RAFHA2413/Control_Navegacion_USV_STM32H562VGT6_v03/Evidencias_Experimentales/README.md

# Evidencias experimentales — PCB de control de navegación USV

Este directorio reúne **copias íntegras** de los archivos entregados en `PRUEBAS DE LA PCB.zip`. Se conserva el nombre y el contenido original de cada archivo; únicamente cambia su ubicación.

## Criterio de organización

Se agrupan los registros por código P01–P19 cuando aparece en el nombre original y, dentro de cada prueba, por formato. Los registros adicionales de inclinación y propulsión se asignaron **provisionalmente** por el nombre del archivo. Esta clasificación **no implica aprobación, conformidad ni ejecución completa** de un protocolo.

| Grupo | Archivos |
|---|---:|
| `P03` | 3 |
| `P04` | 3 |
| `P04_IMU_Adicional` | 1 |
| `P05` | 13 |
| `P06` | 4 |
| `P07` | 2 |
| `P08` | 3 |
| `P12` | 2 |
| `P13_P14_Propulsion` | 2 |
| `P13_P14_Propulsion_Adicional` | 1 |
| `P16` | 3 |
| `P17` | 2 |

## Integridad y trazabilidad

`INDICE_EVIDENCIAS.csv` contiene ruta, tamaño y SHA-256 de cada archivo. Los `.zip` internos se mantienen sin descomprimir para preservar la evidencia de origen y sus propios archivos auxiliares. Se conservan los archivos redundantes de las comparativas GNSS por pertenecer a paquetes originales.

## Interpretación de los datos

Estos ficheros son evidencias brutas o de análisis, no certificados de cumplimiento. Cualquier conclusión científica debe basarse en un análisis independiente de los registros y en los criterios definidos en el artículo y sus anexos. La existencia de un archivo con código de prueba no acredita por sí sola su resultado.

## Advertencia de publicación

**Revisar antes de enviar a un repositorio público.** Los archivos de P05 y sus ZIP auxiliares incluyen o pueden incluir latitudes, longitudes, trayectorias, fechas y horarios. Verificar autorizaciones institucionales y posibles datos sensibles de cualquier otro archivo. No publicar rutas operacionales no autorizadas.

## Fuente

Archivo suministrado por los autores: `PRUEBAS DE LA PCB.zip`. Inventario preparado el 22 de octubre de 2026.
