RAFHA2413/Control_Navegacion_USV_STM32H562VGT6_v03/Evidencias_Experimentales/P03/Analisis_XLSX/USV0067_PCB_A193_Informe_Analisis_P03_19OCT2026.xlsx

Sheet: Resumen
USV 0067 | PCB A193 — Informe de telemetría inicial
Registro P-03 · Análisis exploratorio, no acta de aprobación funcional
Dato | Resultado | Dato | Resultado
Fecha y hora local (UTC−5) | 2026-10-19 19:57:19 | Fin (UTC−5) | 2026-10-19 19:57:34
Duración exacta del CSV (s) | 14.598 | Filas de eventos | 1491
Variables por UART | 52 | Actualizaciones por variable | 30
Velocidad estimada (Hz) | 2.06 | Fuente | CSV original Teleplot
Firmware | Modo banco 13.2 + cambios locales | Tipo de conexión | USART6 TX → USB–TTL → COM5
Hallazgos que sí se desprenden del archivo
Área | Evidencia registrada | Dictamen limitado | Siguiente verificación
P-02 | firmware | main_alive 771→785 | Ejecución durante la captura | Prueba prolongada y revisar HardFault
P-03 | UART6 | 52 variables; 30 valores cada una | Transmisión PCB→PC | Enviar PCB STATUS con LF
P-04 | IMU | imu_ok=1, imu_data_ok=1 | Datos recibidos | Inclinación con referencia angular
P-05 | GNSS | gnss_rx_bytes=0 | Sin recepción observada | Comprobar conexión y salida L76K
P-06 | DS18B20 | temperatura_c = −100 °C | Lectura inválida | Inspeccionar 1-Wire J22 y pull-up
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
