RAFHA2413/Control_Navegacion_USV_STM32H562VGT6_v03/Evidencias_Experimentales/P20_P29/24_USV_P20_P29_.xlsx

Sheet: RESUMEN
VALIDACIÓN DE DATOS P20–P29
Prueba | Medida | Resultado | Unidad | Fuente anexo | PRINCIPIOS DE INTERPRETACIÓN
P20 | Corriente media E4 | 0.510 | A | I - Tabla I2 | Este archivo es copia corregida del libro P20–P29; no se alteran observaciones de las hojas de ensayo. | E0 | 0.1800003833 | 2.1600046
P20 | Pico de corriente E4 | 0.910 | A | I - Tabla I2 | Las modificaciones de la hoja RESUMEN corrigen fórmulas y referencias a Tablas I2–I6/J4–J8 de la versión 22. | E1 | 0.2400004167 | 2.880005
P21 | Mínimo línea 3,3 V | 3.230 | V | I - Tabla I3 | P20: potencia = corriente media × 12,0 V medidos; no se dispone de V(t) e I(t) simultáneas. | E2 | 0.2900004 | 3.4800048
P21 | Mínimo línea 5 V | 4.820 | V | I - Tabla I3 | P21: rizado y recuperación reportados con osciloscopio; faltan archivos de forma de onda originales. | E3 | 0.4600004167 | 5.520005
P22 | Regulador 5 V a 30 min | 49.000 | °C | I - Tabla I4 | P22: 21 °C corresponde al ambiente de laboratorio; temperaturas de componentes son superficiales reportadas. | E4 | 0.5100004 | 6.1200048
P23 | Media ciclo global | 6.700 | ms | I - Tabla I5 | P23: duración informada por Teleplot sin cronometraje externo de contraste.
P23 | Máximo ciclo global | 11.800 | ms | I - Tabla I5 | P24: las categorías de órdenes constituyen subconjuntos de las 300 transmisiones.
P24 | Recepciones XBee registradas válidas | 298.000 | tramas | I - Tabla I6 | P26: CRC recalculado en Excel; NO demuestra rechazo automático en estación de tierra. | Minuto | Temp. regulador 5V (°C)
P24 | Transmisiones XBee registradas | 300.000 | tramas | I - Tabla I6 | P28/P29: las mismas 3.000 transmisiones se analizan en ambas hojas; no sumar como 6.000. | 0 | 25
P25 | Comandos conformes aceptados | 100.000 | casos | J - Tabla J4 | P29: diferencias entre marcas temporales Teleplot, no latencia radio unidireccional calibrada. | 10 | 38
P25 | Comandos defectuosos rechazados | 30.000 | casos | J - Tabla J4 | P29: 30/30 estados lógicos neutros; no sustituyen medida física PWM ni frenado. | 20 | 46
P26 | Tramas con CRC discrepante (recalculado en Excel) | 30.000 | tramas | J - Tabla J5 | Pruebas de mar: fuera del alcance evaluado del artículo, conforme a información de los autores. | 30 | 49
P27 | Casos clasificados por categoría registrada | 145.000 | casos | J - Tabla J6
P28 | Paquetes válidos recibidos | 2994.000 | tramas | J - Tabla J7
P29 | Tramas válidas del enlace | 2994.000 | tramas | J - Tabla J8
P29 | Órdenes de parada lógicas | 30.000 | comandos | J - Tabla J8
P29 | Diferencia temporal media registrada (estimada) | 45.000 | ms | J - Tabla J8
P29 | Diferencia temporal máxima registrada (estimada) | 96.000 | ms | J - Tabla J8

Sheet: P20_Consumo
P20_Consumo
prueba | etapa | condicion | t_relativo_ms | vin_V | i_entrada_A | p_entrada_W | marca_pico
P20 | E0 | PCB sin actuacion | 0 | 12 | 0.179317 | 2.151804 | 0
P20 | E0 | PCB sin actuacion | 1000 | 12 | 0.179955 | 2.15946 | 0
P20 | E0 | PCB sin actuacion | 2000 | 12 | 0.180585 | 2.16702 | 0
P20 | E0 | PCB sin actuacion | 3000 | 12 | 0.181201 | 2.174412 | 0
P20 | E0 | PCB sin actuacion | 4000 | 12 | 0.181796 | 2.181552 | 0
P20 | E0 | PCB sin actuacion | 5000 | 12 | 0.182363 | 2.188356 | 0
P20 | E0 | PCB sin actuacion | 6000 | 12 | 0.182895 | 2.19474 | 0
P20 | E0 | PCB sin actuacion | 7000 | 12 | 0.183387 | 2.200644 | 0
P20 | E0 | PCB sin actuacion | 8000 | 12 | 0.183832 | 2.205984 | 0
P20 | E0 | PCB sin actuacion | 9000 | 12 | 0.184227 | 2.210724 | 0
P20 | E0 | PCB sin actuacion | 10000 | 12 | 0.184566 | 2.214792 | 0
P20 | E0 | PCB sin actuacion | 11000 | 12 | 0.184845 | 2.21814 | 0
P20 | E0 | PCB sin actuacion | 12000 | 12 | 0.185062 | 2.220744 | 0
P20 | E0 | PCB sin actuacion | 13000 | 12 | 0.185213 | 2.222556 | 0
P20 | E0 | PCB sin actuacion | 14000 | 12 | 0.185298 | 2.223576 | 0
P20 | E0 | PCB sin actuacion | 15000 | 12 | 0.185315 | 2.22378 | 0
P20 | E0 | PCB sin actuacion | 16000 | 12 | 0.185264 | 2.223168 | 0
P20 | E0 | PCB sin actuacion | 17000 | 12 | 0.185146 | 2.221752 | 0
P20 | E0 | PCB sin actuacion | 18000 | 12 | 0.184961 | 2.219532 | 0
P20 | E0 | PCB sin actuacion | 19000 | 12 | 0.184713 | 2.216556 | 0
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
P20 | E4 | E3 + ordenes de motores y bomba (potencia externa) | 243000 | 12 | 0.5051 | 6.0612 | 0
P20 | E4 | E3 + ordenes de motores y bomba (potencia externa) | 244000 | 12 | 0.505695 | 6.06834 | 0
P20 | E4 | E3 + ordenes de motores y bomba (potencia externa) | 245000 | 12 | 0.506261 | 6.075132 | 0
P20 | E4 | E3 + ordenes de motores y bomba (potencia externa) | 246000 | 12 | 0.506794 | 6.081528 | 0
P20 | E4 | E3 + ordenes de motores y bomba (potencia externa) | 247000 | 12 | 0.507285 | 6.08742 | 0
P20 | E4 | E3 + ordenes de motores y bomba (potencia externa) | 248000 | 12 | 0.507731 | 6.092772 | 0
P20 | E4 | E3 + ordenes de motores y bomba (potencia externa) | 249000 | 12 | 0.508125 | 6.0975 | 0
P20 | E4 | E3 + ordenes de motores y bomba (potencia externa) | 250000 | 12 | 0.508464 | 6.101568 | 0
P20 | E4 | E3 + ordenes de motores y bomba (potencia externa) | 251000 | 12 | 0.508743 | 6.104916 | 0
P20 | E4 | E3 + ordenes de motores y bomba (potencia externa) | 252000 | 12 | 0.50896 | 6.10752 | 0
P20 | E4 | E3 + ordenes de motores y bomba (potencia externa) | 253000 | 12 | 0.509111 | 6.109332 | 0
P20 | E4 | E3 + ordenes de motores y bomba (potencia externa) | 254000 | 12 | 0.509196 | 6.110352 | 0
P20 | E4 | E3 + ordenes de motores y bomba (potencia externa) | 255000 | 12 | 0.509213 | 6.110556 | 0
P20 | E4 | E3 + ordenes de motores y bomba (potencia externa) | 256000 | 12 | 0.509162 | 6.109944 | 0
P20 | E4 | E3 + ordenes de motores y bomba (potencia externa) | 257000 | 12 | 0.509044 | 6.108528 | 0
P20 | E4 | E3 + ordenes de motores y bomba (potencia externa) | 258000 | 12 | 0.50886 | 6.10632 | 0
P20 | E4 | E3 + ordenes de motores y bomba (potencia externa) | 259000 | 12 | 0.508611 | 6.103332 | 0
P20 | E4 | E3 + ordenes de motores y bomba (potencia externa) | 260000 | 12 | 0.508302 | 6.099624 | 0
P20 | E4 | E3 + ordenes de motores y bomba (potencia externa) | 261000 | 12 | 0.507935 | 6.09522 | 0
P20 | E4 | E3 + ordenes de motores y bomba (potencia externa) | 262000 | 12 | 0.507514 | 6.090168 | 0
P20 | E4 | E3 + ordenes de motores y bomba (potencia externa) | 263000 | 12 | 0.507045 | 6.08454 | 0
P20 | E4 | E3 + ordenes de motores y bomba (potencia externa) | 264000 | 12 | 0.506532 | 6.078384 | 0
P20 | E4 | E3 + ordenes de motores y bomba (potencia externa) | 265000 | 12 | 0.505982 | 6.071784 | 0
P20 | E4 | E3 + ordenes de motores y bomba (potencia externa) | 266000 | 12 | 0.5054 | 6.0648 | 0
P20 | E4 | E3 + ordenes de motores y bomba (potencia externa) | 267000 | 12 | 0.504794 | 6.057528 | 0
P20 | E4 | E3 + ordenes de motores y bomba (potencia externa) | 268000 | 12 | 0.50417 | 6.05004 | 0
P20 | E4 | E3 + ordenes de motores y bomba (potencia externa) | 269000 | 12 | 0.503535 | 6.04242 | 0
P20 | E4 | E3 + ordenes de motores y bomba (potencia externa) | 270000 | 12 | 0.91 | 10.92 | 1
P20 | E4 | E3 + ordenes de motores y bomba (potencia externa) | 271000 | 12 | 0.502261 | 6.027132 | 0
P20 | E4 | E3 + ordenes de motores y bomba (potencia externa) | 272000 | 12 | 0.501637 | 6.019644 | 0
P20 | E4 | E3 + ordenes de motores y bomba (potencia externa) | 273000 | 12 | 0.50103 | 6.01236 | 0
P20 | E4 | E3 + ordenes de motores y bomba (potencia externa) | 274000 | 12 | 0.500449 | 6.005388 | 0
P20 | E4 | E3 + ordenes de motores y bomba (potencia externa) | 275000 | 12 | 0.499899 | 5.998788 | 0
P20 | E4 | E3 + ordenes de motores y bomba (potencia externa) | 276000 | 12 | 0.499386 | 5.992632 | 0
P20 | E4 | E3 + ordenes de motores y bomba (potencia externa) | 277000 | 12 | 0.498917 | 5.987004 | 0
P20 | E4 | E3 + ordenes de motores y bomba (potencia externa) | 278000 | 12 | 0.498496 | 5.981952 | 0
P20 | E4 | E3 + ordenes de motores y bomba (potencia externa) | 279000 | 12 | 0.498129 | 5.977548 | 0
P20 | E4 | E3 + ordenes de motores y bomba (potencia externa) | 280000 | 12 | 0.497819 | 5.973828 | 0
P20 | E4 | E3 + ordenes de motores y bomba (potencia externa) | 281000 | 12 | 0.497571 | 5.970852 | 0
P20 | E4 | E3 + ordenes de motores y bomba (potencia externa) | 282000 | 12 | 0.497387 | 5.968644 | 0
P20 | E4 | E3 + ordenes de motores y bomba (potencia externa) | 283000 | 12 | 0.497268 | 5.967216 | 0
P20 | E4 | E3 + ordenes de motores y bomba (potencia externa) | 284000 | 12 | 0.497217 | 5.966604 | 0
P20 | E4 | E3 + ordenes de motores y bomba (potencia externa) | 285000 | 12 | 0.497234 | 5.966808 | 0
P20 | E4 | E3 + ordenes de motores y bomba (potencia externa) | 286000 | 12 | 0.497319 | 5.967828 | 0
P20 | E4 | E3 + ordenes de motores y bomba (potencia externa) | 287000 | 12 | 0.497471 | 5.969652 | 0
P20 | E4 | E3 + ordenes de motores y bomba (potencia externa) | 288000 | 12 | 0.497687 | 5.972244 | 0
P20 | E4 | E3 + ordenes de motores y bomba (potencia externa) | 289000 | 12 | 0.497967 | 5.975604 | 0
P20 | E4 | E3 + ordenes de motores y bomba (potencia externa) | 290000 | 12 | 0.498306 | 5.979672 | 0
P20 | E4 | E3 + ordenes de motores y bomba (potencia externa) | 291000 | 12 | 0.4987 | 5.9844 | 0
P20 | E4 | E3 + ordenes de motores y bomba (potencia externa) | 292000 | 12 | 0.499145 | 5.98974 | 0
P20 | E4 | E3 + ordenes de motores y bomba (potencia externa) | 293000 | 12 | 0.499637 | 5.995644 | 0
P20 | E4 | E3 + ordenes de motores y bomba (potencia externa) | 294000 | 12 | 0.500169 | 6.002028 | 0
P20 | E4 | E3 + ordenes de motores y bomba (potencia externa) | 295000 | 12 | 0.500736 | 6.008832 | 0
P20 | E4 | E3 + ordenes de motores y bomba (potencia externa) | 296000 | 12 | 0.501331 | 6.015972 | 0
P20 | E4 | E3 + ordenes de motores y bomba (potencia externa) | 297000 | 12 | 0.501947 | 6.023364 | 0
P20 | E4 | E3 + ordenes de motores y bomba (potencia externa) | 298000 | 12 | 0.502578 | 6.030936 | 0
P20 | E4 | E3 + ordenes de motores y bomba (potencia externa) | 299000 | 12 | 0.503215 | 6.03858 | 0

Sheet: P23_Tiempos
P23_Tiempos
prueba | tarea | ciclo_n | t_teorico_ms | duracion_ms | plazo_ms | fuera_de_plazo
P23 | IMU_I2C1 | 1 | 20 | 1.762715 | 20 | 0
P23 | IMU_I2C1 | 2 | 40 | 1.79667 | 20 | 0
P23 | IMU_I2C1 | 3 | 60 | 2.276 | 20 | 0
P23 | IMU_I2C1 | 4 | 80 | 2.016245 | 20 | 0
P23 | IMU_I2C1 | 5 | 100 | 1.498999 | 20 | 0
P23 | IMU_I2C1 | 6 | 120 | 2.086418 | 20 | 0
P23 | IMU_I2C1 | 7 | 140 | 2.073968 | 20 | 0
P23 | IMU_I2C1 | 8 | 160 | 1.211515 | 20 | 0
P23 | IMU_I2C1 | 9 | 180 | 1.879293 | 20 | 0
P23 | IMU_I2C1 | 10 | 200 | 1.887216 | 20 | 0
P23 | IMU_I2C1 | 11 | 220 | 1.150396 | 20 | 0
P23 | IMU_I2C1 | 12 | 240 | 1.813647 | 20 | 0
P23 | IMU_I2C1 | 13 | 260 | 1.603127 | 20 | 0
P23 | IMU_I2C1 | 14 | 280 | 1.443539 | 20 | 0
P23 | IMU_I2C1 | 15 | 300 | 1.655191 | 20 | 0
P23 | IMU_I2C1 | 16 | 320 | 1.565777 | 20 | 0
P23 | IMU_I2C1 | 17 | 340 | 1.900798 | 20 | 0
P23 | IMU_I2C1 | 18 | 360 | 2.196 | 20 | 0
P23 | IMU_I2C1 | 19 | 380 | 2.059254 | 20 | 0
P23 | IMU_I2C1 | 20 | 400 | 1.025894 | 20 | 0
P23 | IMU_I2C1 | 21 | 420 | 1.999267 | 20 | 0
P23 | IMU_I2C1 | 22 | 440 | 1.188878 | 20 | 0
P23 | IMU_I2C1 | 23 | 460 | 1.724233 | 20 | 0
P23 | IMU_I2C1 | 24 | 480 | 2.372 | 20 | 0
P23 | IMU_I2C1 | 25 | 500 | 2.061518 | 20 | 0
P23 | IMU_I2C1 | 26 | 520 | 1.313379 | 20 | 0
P23 | IMU_I2C1 | 27 | 540 | 1.168505 | 20 | 0
P23 | IMU_I2C1 | 28 | 560 | 1.884953 | 20 | 0
P23 | IMU_I2C1 | 29 | 580 | 1.707256 | 20 | 0
P23 | IMU_I2C1 | 30 | 600 | 1.237547 | 20 | 0
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
P23 | GNSS_US2 | 948 | 18960 | 0.524 | 20 | 0
P23 | GNSS_US2 | 949 | 18980 | 0.192373 | 20 | 0
P23 | GNSS_US2 | 950 | 19000 | 0.360109 | 20 | 0
P23 | GNSS_US2 | 951 | 19020 | 0.141014 | 20 | 0
P23 | GNSS_US2 | 952 | 19040 | 0.116373 | 20 | 0
P23 | GNSS_US2 | 953 | 19060 | 0.358031 | 20 | 0
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
