RAFHA2413/Control_Navegacion_USV_STM32H562VGT6_v03/Evidencias_Experimentales/INDICE_EVIDENCIAS.csv

codigo | tipo | archivo_original | ruta_relativa_en_paquete | bytes | sha256 | revision_publicacion
P03 | Analisis_XLSX | USV0067_PCB_A193_Informe_Analisis_P03_19OCT2026.xlsx | Evidencias_Experimentales/P03/Analisis_XLSX/USV0067_PCB_A193_Informe_Analisis_P03_19OCT2026.xlsx | 24751 | bf0d75cfed051277d66af35bf1fa67078f6775406b0299e3707b728b5551e502 | REVISAR_ANTES_DE_PUBLICAR
P03 | Graficas_y_Capturas | USV0067_PCB_A193_P03_UART6_Bidireccional_19OCT2026.png | Evidencias_Experimentales/P03/Graficas_y_Capturas/USV0067_PCB_A193_P03_UART6_Bidireccional_19OCT2026.png | 17008 | 0533cbf86c8d818af36d077606af17375cca2fefee244ee0420ba54a16f95037 | REVISAR_ANTES_DE_PUBLICAR
P03 | Registros_CSV | USV0067_PCB_A193_P03_Telemetria_Inicial_19OCT2026.csv | Evidencias_Experimentales/P03/Registros_CSV/USV0067_PCB_A193_P03_Telemetria_Inicial_19OCT2026.csv | 111140 | 077dfe2401a4587d238d4d108e9b397a6d4f7e06448e2f086d27c1a16f515104 | REVISAR_ANTES_DE_PUBLICAR
P04 | Registros_CSV | USV0067_PCB_A193_P04_IMU_Inclinacion_Lateral_19OCT2026.csv | Evidencias_Experimentales/P04/Registros_CSV/USV0067_PCB_A193_P04_IMU_Inclinacion_Lateral_19OCT2026.csv | 441700 | ffc191726b85a3fc6f24683c7584b86ada8407888aff66dc182baee0d2ff4e77 | REVISAR_ANTES_DE_PUBLICAR
P04 | Registros_CSV | USV0067_PCB_A193_P04_IMU_Movimiento_Exploratorio_19OCT2026.csv | Evidencias_Experimentales/P04/Registros_CSV/USV0067_PCB_A193_P04_IMU_Movimiento_Exploratorio_19OCT2026.csv | 223344 | 7305ba545b251598d1a0d17ec8b7f18799f04f3281cfc216d018aa40e5c0391b | REVISAR_ANTES_DE_PUBLICAR
P04 | Registros_CSV | USV0067_PCB_A193_P04_IMU_en_reposo_19OCT2026.csv | Evidencias_Experimentales/P04/Registros_CSV/USV0067_PCB_A193_P04_IMU_en_reposo_19OCT2026.csv | 221884 | a51f12714ee97c997bb390b60845492aedc58571a83ad200ef7fd156500c48f8 | REVISAR_ANTES_DE_PUBLICAR
P04_IMU_Adicional | Registros_CSV | inclinacion 15 grados .csv | Evidencias_Experimentales/P04_IMU_Adicional/Registros_CSV/inclinacion 15 grados .csv | 447880 | 775ffbfead5e92cb3cf4b9658a72a1506e55de374ca2289bddc1fbfd12439648 | REVISAR_ANTES_DE_PUBLICAR
P05 | Graficas_y_Capturas | USV0067_PCB_A193_P05_GNSS_RMC_GGA_Corregido_20OCT2026.png | Evidencias_Experimentales/P05/Graficas_y_Capturas/USV0067_PCB_A193_P05_GNSS_RMC_GGA_Corregido_20OCT2026.png | 125549 | ee1bdf03bffd92ed02f7a4de6a99d6c72ccb1553ee5a3a21c0541a2ece50102d | REVISAR_COORDENADAS
P05 | Graficas_y_Capturas | USV0067_PCB_A193_P05_GNSS_Variacion_Posicion_19OCT2026.png | Evidencias_Experimentales/P05/Graficas_y_Capturas/USV0067_PCB_A193_P05_GNSS_Variacion_Posicion_19OCT2026.png | 118169 | 5433a75692fdf3b61665f611204fec34ff5409235d457fbec31ab6ad0ce80286 | REVISAR_COORDENADAS
P05 | Paquetes_Complementarios | USV0067_P05_Evidencias_Comparativa_GNSS_FIT_20OCT2026.zip | Evidencias_Experimentales/P05/Paquetes_Complementarios/USV0067_P05_Evidencias_Comparativa_GNSS_FIT_20OCT2026.zip | 342068 | 085fd778043fde5c8cd554c80a43a0543776273310c5d1a2f5913f035182b95e | REVISAR_COORDENADAS
P05 | Paquetes_Complementarios | USV0067_P05_Evidencias_Tres_GPS_20OCT2026.zip | Evidencias_Experimentales/P05/Paquetes_Complementarios/USV0067_P05_Evidencias_Tres_GPS_20OCT2026.zip | 551925 | 58ac74c57a4f7796706f93ac68605524fade98d2f5c0a594fd405641b0637f8b | REVISAR_COORDENADAS
P05 | Paquetes_Complementarios | USV0067_P05_GNSS_Cielo_Evidencias_20OCT2026.zip | Evidencias_Experimentales/P05/Paquetes_Complementarios/USV0067_P05_GNSS_Cielo_Evidencias_20OCT2026.zip | 199744 | 921075cea0313021363fdafb6e3171c4e03c9bf523ad626859a8d4cb94174234 | REVISAR_COORDENADAS
P05 | Registros_CSV | USV0067_P05_Comparacion_GNSS_L76K_vs_Referencia_FIT_20OCT2026.csv | Evidencias_Experimentales/P05/Registros_CSV/USV0067_P05_Comparacion_GNSS_L76K_vs_Referencia_FIT_20OCT2026.csv | 42564 | 45ff96b6b54dd2775295072a915dc42f4f5ec0e7cdaa4e38355306e9bc98fc6f | REVISAR_COORDENADAS
P05 | Registros_CSV | USV0067_P05_Comparacion_Tres_GPS_Alineada_20OCT2026.csv | Evidencias_Experimentales/P05/Registros_CSV/USV0067_P05_Comparacion_Tres_GPS_Alineada_20OCT2026.csv | 65597 | da1701e92f14c6a9ebfc84f27cb0d1a2d7db8084f8164c19decc6d12825d553b | REVISAR_COORDENADAS
P05 | Registros_CSV | USV0067_P05_GNSS_L76K_Comparativa_20OCT2026.csv | Evidencias_Experimentales/P05/Registros_CSV/USV0067_P05_GNSS_L76K_Comparativa_20OCT2026.csv | 2416604 | 6b5eca619f7ae07af19c164fc0abd6c482b156d1f6de7e6fb4c47c0a793defeb | REVISAR_COORDENADAS
P05 | Registros_CSV | USV0067_PCB_A193_P05_GNSS_Prueba_Dinamica_Carro_20OCT2026.csv | Evidencias_Experimentales/P05/Registros_CSV/USV0067_PCB_A193_P05_GNSS_Prueba_Dinamica_Carro_20OCT2026.csv | 2256739 | a3f09924966d42c87e74b1586ff63a3826627d346573d21a8de517de8328eb01 | REVISAR_COORDENADAS
P05 | Registros_CSV | USV0067_PCB_A193_P05_GNSS_Prueba_Estatica_Cielo_20OCT2026.csv | Evidencias_Experimentales/P05/Registros_CSV/USV0067_PCB_A193_P05_GNSS_Prueba_Estatica_Cielo_20OCT2026.csv | 811132 | 0eb7c1f0146f987016c191a6e0db3b5063b097111f2b880fe95816263292a925 | REVISAR_COORDENADAS
P05 | Registros_CSV | USV0067_PCB_A193_P05_GNSS_RMC_GGA_Corregido_20OCT2026.csv | Evidencias_Experimentales/P05/Registros_CSV/USV0067_PCB_A193_P05_GNSS_RMC_GGA_Corregido_20OCT2026.csv | 626098 | c5cd3f58943404af2e44ac69da8c30d0c700d48b1211f2a68cc9230235f1c260 | REVISAR_COORDENADAS
P05 | Registros_CSV | USV0067_PCB_A193_P05_GNSS_Validacion_RMC_GGA_V2_20OCT2026.csv | Evidencias_Experimentales/P05/Registros_CSV/USV0067_PCB_A193_P05_GNSS_Validacion_RMC_GGA_V2_20OCT2026.csv | 636464 | 9f3f2a8e539f5481765515949d3bc2a65ee634401fc1d44b63ada9ef10873e6b | REVISAR_COORDENADAS
P05 | Registros_CSV | USV0067_PCB_A193_P05_GPS_GNSS_L76K_19OCT2026.csv | Evidencias_Experimentales/P05/Registros_CSV/USV0067_PCB_A193_P05_GPS_GNSS_L76K_19OCT2026.csv | 449983 | 46fa1d5f4a479c796fc9ad884102f4119079d0b2aedddf78ea7a0149665aa157 | REVISAR_COORDENADAS
P06 | Graficas_y_Capturas | USV0067_PCB_A193_P06_DS18B20_Enfriamiento_Grafica_19OCT2026.png | Evidencias_Experimentales/P06/Graficas_y_Capturas/USV0067_PCB_A193_P06_DS18B20_Enfriamiento_Grafica_19OCT2026.png | 81692 | d74e1b7328b3efb22de7b23bbf2dcc797467ba05aa13b5ac682af0956caf06ce | REVISAR_ANTES_DE_PUBLICAR
P06 | Graficas_y_Capturas | USV0067_PCB_A193_P06_Grafica_Temperatura_DS18B20_19OCT2026.png | Evidencias_Experimentales/P06/Graficas_y_Capturas/USV0067_PCB_A193_P06_Grafica_Temperatura_DS18B20_19OCT2026.png | 82301 | 6d63b48b94362a8c1c1f7c7fd0d61c8b9346c7d431b7a170b106b52bb8fdf16a | REVISAR_ANTES_DE_PUBLICAR
P06 | Registros_CSV | USV0067_PCB_A193_P06_DS18B20_Enfriamiento_19OCT2026.csv | Evidencias_Experimentales/P06/Registros_CSV/USV0067_PCB_A193_P06_DS18B20_Enfriamiento_19OCT2026.csv | 445116 | af4497b67bc8c00dcd7ebfda230b1c1ef3584c6333001441f0daf66de6737bbe | REVISAR_ANTES_DE_PUBLICAR
P06 | Registros_CSV | USV0067_PCB_A193_P06_Temperatura_DS18B20_19OCT2026.csv | Evidencias_Experimentales/P06/Registros_CSV/USV0067_PCB_A193_P06_Temperatura_DS18B20_19OCT2026.csv | 395108 | f638c14306b3b12ccdc4e03151b5773ba5eb50e5d70c2e1b919e4f3069b0823a | REVISAR_ANTES_DE_PUBLICAR
P07 | Graficas_y_Capturas | USV0067_PCB_A193_P07_Respuesta_Humedad_19OCT2026.png | Evidencias_Experimentales/P07/Graficas_y_Capturas/USV0067_PCB_A193_P07_Respuesta_Humedad_19OCT2026.png | 114164 | d604beb74ae249c3cb4fed6b0345939accaae9b3e5d33558e3a533b4fe6a3786 | REVISAR_ANTES_DE_PUBLICAR
P07 | Registros_CSV | USV0067_PCB_A193_P07_Humedad_Deteccion_Agua_19OCT2026.csv | Evidencias_Experimentales/P07/Registros_CSV/USV0067_PCB_A193_P07_Humedad_Deteccion_Agua_19OCT2026.csv | 390582 | 16ae3d32ff3e8de5b6e529fcad5e0c36241890544cefb2ecb1070c8ff1179ab5 | REVISAR_ANTES_DE_PUBLICAR
P08 | Graficas_y_Capturas | USV0067_PCB_A193_P08_Grafica_Voltaje_Bateria_19OCT2026.png | Evidencias_Experimentales/P08/Graficas_y_Capturas/USV0067_PCB_A193_P08_Grafica_Voltaje_Bateria_19OCT2026.png | 212248 | 94fbc97e29e995c2d1f45224045d2ef87a8711c54b2f6ab309d8c4edc282e9b7 | REVISAR_ANTES_DE_PUBLICAR
P08 | Graficas_y_Capturas | USV0067_PCB_A193_P08_Voltaje_Bateria_19OCT2026.png | Evidencias_Experimentales/P08/Graficas_y_Capturas/USV0067_PCB_A193_P08_Voltaje_Bateria_19OCT2026.png | 57930 | 08bf636507fd737afedbd11a6e87d056e6d01f58e6f4e90b263f1d27aac74d4e | REVISAR_ANTES_DE_PUBLICAR
P08 | Registros_CSV | USV0067_PCB_A193_P08_Voltaje_Bateria_19OCT2026.csv | Evidencias_Experimentales/P08/Registros_CSV/USV0067_PCB_A193_P08_Voltaje_Bateria_19OCT2026.csv | 441023 | d721cd8a39a1e9092b25fc38528b2bcf2a3c504ad3ece59dfb3be2e76ddd0c81 | REVISAR_ANTES_DE_PUBLICAR
P12 | Graficas_y_Capturas | USV 0067 — Prueba P-12_ secuencia de control del servomotor MG996R.png | Evidencias_Experimentales/P12/Graficas_y_Capturas/USV 0067 — Prueba P-12_ secuencia de control del servomotor MG996R.png | 23116 | 7ac243bdf4b12c16bbc881b95d1b01f2274927a0148db5f62894bc4707728237 | REVISAR_ANTES_DE_PUBLICAR
P12 | Registros_CSV | USV0067_PCB_A193_P12_Servo_MG996R_Movimiento_19OCT2026.csv | Evidencias_Experimentales/P12/Registros_CSV/USV0067_PCB_A193_P12_Servo_MG996R_Movimiento_19OCT2026.csv | 437599 | 97a58ada972c4a2b1ac1e8398fbc95fbd65a00d1a5c791b34dbce121f328b09a | REVISAR_ANTES_DE_PUBLICAR
P13_P14_Propulsion | Graficas_y_Capturas | USV0067_PCB_A193_P13_P14_Grafica_PWM_19OCT2026.png | Evidencias_Experimentales/P13_P14_Propulsion/Graficas_y_Capturas/USV0067_PCB_A193_P13_P14_Grafica_PWM_19OCT2026.png | 106239 | 5edd589e57f6b0512513f601c9a903bfa6ff9b4e2d74b2b958fd2eae50e11ab3 | REVISAR_ANTES_DE_PUBLICAR
P13_P14_Propulsion | Registros_CSV | USV0067_PCB_A193_P13_P14_Accionamiento_Motores_19OCT2026.csv | Evidencias_Experimentales/P13_P14_Propulsion/Registros_CSV/USV0067_PCB_A193_P13_P14_Accionamiento_Motores_19OCT2026.csv | 440691 | 34e1292d1ca341d6a12e23d8d1c8ae28004d800767ee59b6d5aa1bf93eff382b | REVISAR_ANTES_DE_PUBLICAR
P13_P14_Propulsion_Adicional | Registros_CSV | PRUEBAS PULSO MOTORES ESTRIBOR Y BABOR.csv | Evidencias_Experimentales/P13_P14_Propulsion_Adicional/Registros_CSV/PRUEBAS PULSO MOTORES ESTRIBOR Y BABOR.csv | 350623 | cd82d1d659e9422236ba34175315e6a6d370a7d2bed3379fa0e61b940eda2647 | REVISAR_ANTES_DE_PUBLICAR
P16 | Graficas_y_Capturas | USV0067_PCB_A193_P16_Bomba_Achique_19OCT2026.png | Evidencias_Experimentales/P16/Graficas_y_Capturas/USV0067_PCB_A193_P16_Bomba_Achique_19OCT2026.png | 9121 | 627703ae0b021b07eb0bb642e6ea1c4178c34db692d37fb995d5cf6a97ec8351 | REVISAR_ANTES_DE_PUBLICAR
P16 | Graficas_y_Capturas | USV0067_PCB_A193_P16_Bomba_Control_Teleplot.png | Evidencias_Experimentales/P16/Graficas_y_Capturas/USV0067_PCB_A193_P16_Bomba_Control_Teleplot.png | 90840 | 336e64a982eceba47c57cda846487d9e65f0983c0bf0354578280e032791aea3 | REVISAR_ANTES_DE_PUBLICAR
P16 | Registros_CSV | USV0067_PCB_A193_P16_Bomba_Achique_19OCT2026.csv | Evidencias_Experimentales/P16/Registros_CSV/USV0067_PCB_A193_P16_Bomba_Achique_19OCT2026.csv | 340270 | 17e2b49b85c98a3b675c38764b66ffdf8f05cc5deb387a1017b53851396a2a5b | REVISAR_ANTES_DE_PUBLICAR
P17 | Graficas_y_Capturas | USV0067_PCB_A193_P17_Seguridad_19OCT2026.png | Evidencias_Experimentales/P17/Graficas_y_Capturas/USV0067_PCB_A193_P17_Seguridad_19OCT2026.png | 8558 | 90adf4dad84a82a95c5cd417c63c3bc49b41acf6d363c152bc89e86971744d76 | REVISAR_ANTES_DE_PUBLICAR
P17 | Registros_CSV | USV0067_PCB_A193_P17_Seguridad_19OCT2026.csv | Evidencias_Experimentales/P17/Registros_CSV/USV0067_PCB_A193_P17_Seguridad_19OCT2026.csv | 442486 | af28d61253d06f3596366f92510c8e6a70d20d44d7dfbe40fdf209797f6cd455 | REVISAR_ANTES_DE_PUBLICAR
