RAFHA2413/Control_Navegacion_USV_STM32H562VGT6_v03/Evidencias_Experimentales/P20_P29/README.md

# Evidencias experimentales P20–P29 de la PCB USV

## Archivo original

- **Nombre esperado:** `24_USV_P20_P29_.xlsx`
- **Formato:** Libro Microsoft Excel (`.xlsx`)
- **Tamaño original:** 700.869 bytes
- **SHA-256 original:** `084a40f7020a8e8a1c7eb6d41e2dc815d8c9b08d050541772f4efa9f78bdcbcb`
- **Estado del libro antes de publicarlo:** estructura ZIP interna íntegra.

El libro contiene las siguientes 11 hojas, según la estructura original:

1. `RESUMEN`
2. `P20_Consumo`
3. `P21_Alimentacion`
4. `P22_Temperaturas`
5. `P23_Tiempos`
6. `P24_Concurrencia`
7. `P25_Formato`
8. `P26_CRC`
9. `P27_Clasificacion`
10. `P28_Paquetes`
11. `P29_Enlace`

## Publicación y verificación

Cargar el archivo original `24_USV_P20_P29_.xlsx` directamente a **esta carpeta**, sin cambiar su nombre ni modificar las hojas. El flujo de GitHub Actions **Verificar Excel P20-P29** contrastará su SHA-256 y la estructura de las 11 hojas, sin alterar los datos. Consultar la pestaña **Actions** para conocer el resultado de la verificación.

La verificación técnica de integridad del archivo no certifica, por sí sola, los resultados del ensayo ni sustituye la revisión metodológica de los anexos I, J y M. Este archivo constituye una evidencia documental complementaria para la trazabilidad de las pruebas.
