RAFHA2413/Control_Navegacion_USV_STM32H562VGT6_v03/Evidencias_Experimentales/P04/Registros_CSV/USV0067_PCB_A193_P04_IMU_Movimiento_Exploratorio_19OCT2026.csv

timestamp(ms) | humedad_adc | humedad_pct | temperatura_c | servo_angulo | servo_pwm_us | cmd_babor_rx_pct | cmd_estribor_rx_pct | cmd_camara_rx_deg | motor_babor_aplicado_pct | motor_estribor_aplicado_pct | motores_pwm_activos | motor_babor_pwm_us | motor_estribor_pwm_us | parada_rx | enlace_tierra_ok | failsafe_tierra | pusvu_rx_validas | bomba_achique | main_alive | imu_ok | imu_addr | imu_data_ok | roll | pitch | yaw | gnss_rx_eventos | gnss_rx_bytes | gps_rmc_ok | gps_gga_ok | gps_fix | gps_satelites | gps_hdop | gps_latitud | gps_longitud | gps_altitud_m | gps_velocidad_kph | gps_rumbo | corriente_adc | corriente_voltaje_v | corriente_a | bateria_adc | bateria_adc_v | bateria_voltaje_v | pcb_armado | pcb_motor_pulso | pcb_bomba_pulso | pcb_do_pulso | di1 | di2 | di3 | di4 | humedad_do
1792460355.774 | 4095
1792460355.776 |  | 0
1792460355.777 |  |  | -100
1792460355.779 |  |  |  | 0
1792460355.78 |  |  |  |  | 1500
1792460355.782 |  |  |  |  |  | 0
1792460355.784 |  |  |  |  |  |  | 0
1792460355.786 |  |  |  |  |  |  |  | 0
1792460355.789 |  |  |  |  |  |  |  |  | 0
1792460355.791 |  |  |  |  |  |  |  |  |  | 0
1792460355.794 |  |  |  |  |  |  |  |  |  |  | 1
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
