RAFHA2413/Control_Navegacion_USV_STM32H562VGT6_v03/Evidencias_Experimentales/P05/Registros_CSV/USV0067_P05_Comparacion_GNSS_L76K_vs_Referencia_FIT_20OCT2026.csv

hora_colombia | tiempo_desde_inicio_s | velocidad_l76k_kmh | velocidad_fit_kmh | diferencia_vel_kmh | error_absoluto_vel_kmh | rumbo_l76k_grados | rumbo_fit_derivado_6s_grados | error_angular_absoluto_grados | latitud_l76k | longitud_l76k | latitud_fit | longitud_fit | separacion_posiciones_m | velocidad_comparable | rumbo_comparable | gnss_rx_bytes_l76k
2026-10-20 10:24:33 | 0.0 | 12.78 | 11.8584 | 0.9216 | 0.9216 | 226.18 | 194.471 | 31.709 | 10.389102 | -75.531416 | 10.3890593 | -75.5314845 | 8.876 | True | True | 239.0
2026-10-20 10:24:34 | 1.0 | 12.2 | 11.7576 | 0.4424 | 0.4424 | 202.02 | 181.012 | 21.008 | 10.389075 | -75.531433 | 10.3890309 | -75.5314908 | 8.007 | True | True | 241.0
2026-10-20 10:24:35 | 2.0 | 12.52 | 11.5884 | 0.9316 | 0.9316 | 186.11 | 165.82 | 20.29 | 10.389045 | -75.531442 | 10.3890004 | -75.5314866 | 6.957 | True | True | 242.0
2026-10-20 10:24:36 | 3.0 | 11.76 | 11.556000000000001 | 0.204 | 0.204 | 174.99 | 153.9 | 21.09 | 10.389015 | -75.531443 | 10.3889755 | -75.5314736 | 5.524 | True | True | 242.0
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
