RAFHA2413/Control_Navegacion_USV_STM32H562VGT6_v03/Evidencias_Experimentales/P05/Registros_CSV/USV0067_P05_Comparacion_Tres_GPS_Alineada_20OCT2026.csv

hora_local_colombia | L76K_velocidad_kmh | Track_velocidad_kmh | FIT_velocidad_kmh | L76K_menos_Track_kmh | L76K_menos_FIT_kmh | L76K_rumbo_grados | Track_rumbo_grados | FIT_rumbo_derivado_6s_grados | comparacion_rumbo_valida_3_mas_8_kmh | L76K_lati_grados | L76K_long_grados | Track_lati_grados | Track_long_grados | FIT_lati_grados | FIT_long_grados | satellites_L76K | HDOP_L76K | GNSS_RX_bytes_L76K | GNSS_rx_eventos_L76K
2026-10-20 11:05:15 | 8.670000 | 9.700000 | 0.000000 | -1.030000 | 8.670000 | 181.890000 | 0.000000 |  | False | 10.389623 | -75.528403 | 10.389785 | -75.528483 | 10.389583 | -75.528437 | 19.000000 | 0.600000 | 219.000000 | 5674.000000
2026-10-20 11:05:16 | 13.150000 | 9.900000 | 0.000000 | 3.250000 | 13.150000 | 184.720000 | 0.000000 |  | False | 10.389595 | -75.528405 | 10.389574 | -75.528456 | 10.389544 | -75.528440 | 19.000000 | 0.600000 | 220.000000 | 5676.000000
2026-10-20 11:05:17 | 12.330000 | 10.800000 | 0.000000 | 1.530000 | 12.330000 | 185.880000 | 0.000000 |  | False | 10.389564 | -75.528408 | 10.389524 | -75.528470 | 10.389487 | -75.528410 | 19.000000 | 0.600000 | 220.000000 | 5678.000000
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
