RAFHA2413/Control_Navegacion_USV_STM32H562VGT6_v03/Evidencias_Experimentales/P05/Registros_CSV/USV0067_PCB_A193_P05_GNSS_Prueba_Estatica_Cielo_20OCT2026.csv

timestamp(ms) | humedad_adc | humedad_pct | temperatura_c | servo_angulo | servo_pwm_us | cmd_babor_rx_pct | cmd_estribor_rx_pct | cmd_camara_rx_deg | motor_babor_aplicado_pct | motor_estribor_aplicado_pct | motores_pwm_activos | motor_babor_pwm_us | motor_estribor_pwm_us | parada_rx | enlace_tierra_ok | failsafe_tierra | pusvu_rx_validas | bomba_achique | main_alive | imu_ok | imu_addr | imu_data_ok | roll | pitch | yaw | gnss_rx_eventos | gnss_rx_bytes | gps_rmc_ok | gps_gga_ok | gps_fix | gps_satelites | gps_hdop | gps_latitud | gps_longitud | gps_altitud_m | gps_velocidad_kph | gps_rumbo | corriente_adc | corriente_voltaje_v | corriente_a | bateria_adc | bateria_adc_v | bateria_voltaje_v | pcb_armado | pcb_motor_pulso | pcb_bomba_pulso | pcb_do_pulso | di1 | di2 | di3 | di4 | humedad_do
1792507290.004 | 4095
1792507290.007 |  | 0
1792507290.008 |  |  | -100
1792507290.01 |  |  |  | 0
1792507290.011 |  |  |  |  | 1500
1792507290.013 |  |  |  |  |  | 0
1792507290.016 |  |  |  |  |  |  | 0
1792507290.017 |  |  |  |  |  |  |  | 0
1792507290.02 |  |  |  |  |  |  |  |  | 0
1792507290.022 |  |  |  |  |  |  |  |  |  | 0
1792507290.025 |  |  |  |  |  |  |  |  |  |  | 1
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
