RAFHA2413/Control_Navegacion_USV_STM32H562VGT6_v03/Evidencias_Experimentales/P05/Graficas_y_Capturas/USV0067_PCB_A193_P05_GNSS_Variacion_Posicion_19OCT2026.png

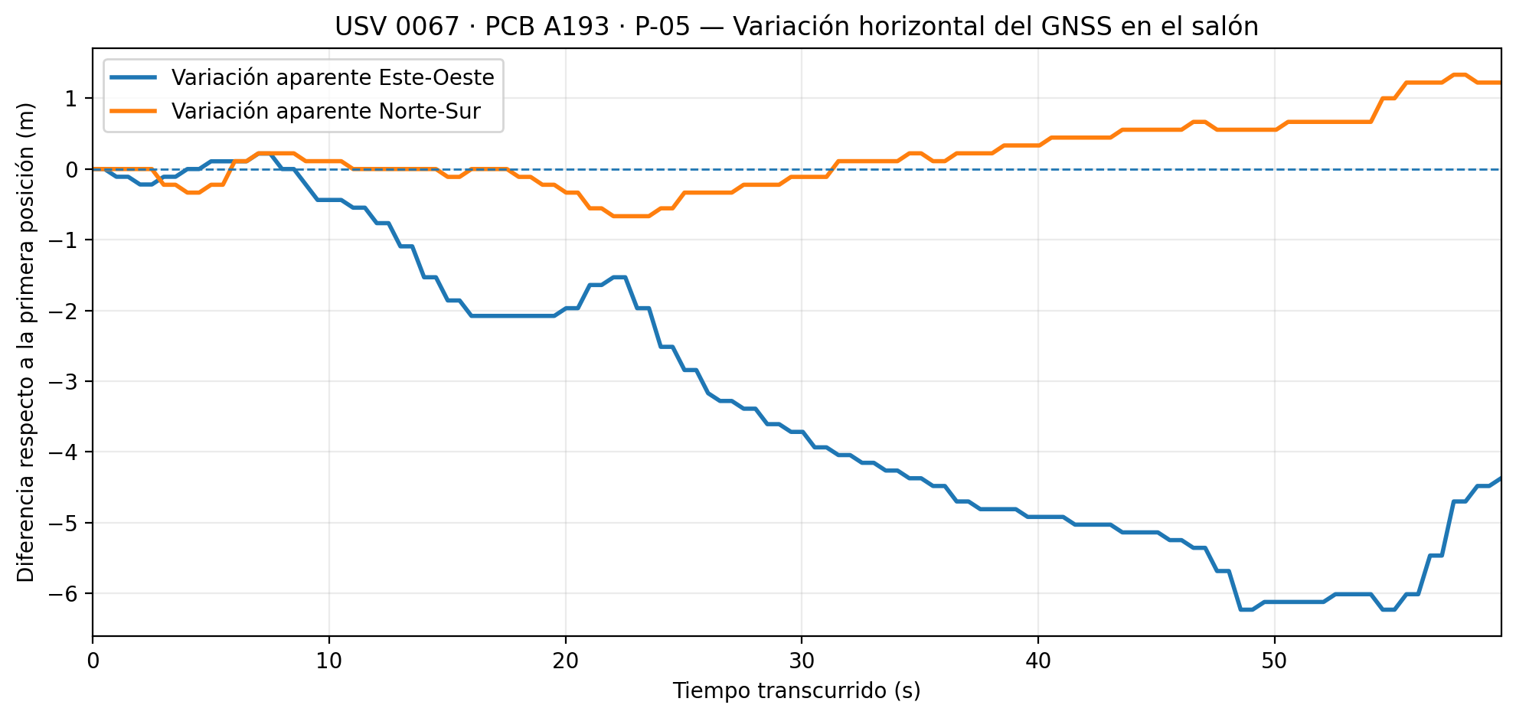
Evidencias_Experimentales/P05/Graficas_y_Capturas/USV0067_PCB_A193_P05_GNSS_Variacion_Posicion_19OCT2026.png
