RAFHA2413/Control_Navegacion_USV_STM32H562VGT6_v03/Evidencias_Experimentales/P08/Graficas_y_Capturas/USV0067_PCB_A193_P08_Grafica_Voltaje_Bateria_19OCT2026.png

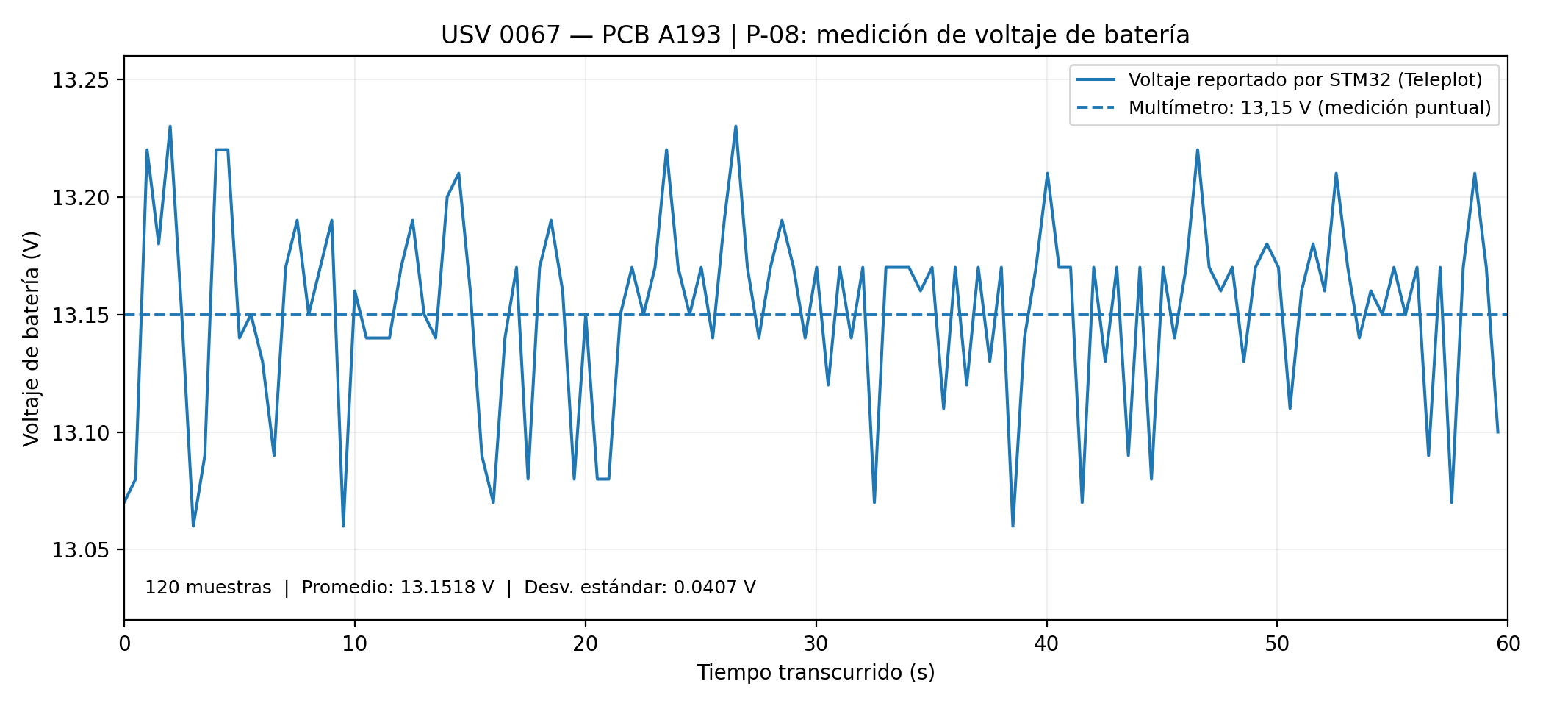
Evidencias_Experimentales/P08/Graficas_y_Capturas/USV0067_PCB_A193_P08_Grafica_Voltaje_Bateria_19OCT2026.png
