RAFHA2413/Control_Navegacion_USV_STM32H562VGT6_v03/Evidencias_Experimentales/P12/Graficas_y_Capturas/USV 0067 — Prueba P-12_ secuencia de control del servomotor MG996R.png

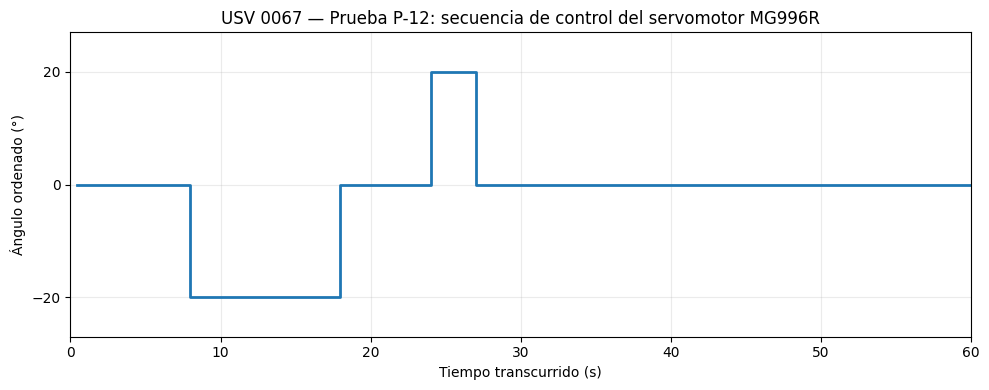
Evidencias_Experimentales/P12/Graficas_y_Capturas/USV 0067 — Prueba P-12_ secuencia de control del servomotor MG996R.png
