RAFHA2413/Control_Navegacion_USV_STM32H562VGT6_v03/Core/Src/main.c

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
/* Includes ------------------------------------------------------------------*/
#include "main.h"

/* USER CODE BEGIN Includes */

#include "servos.h"
#include "UARTRX.h"
#include <stdio.h>
#include "imu_bno085_i2c.h"
#include "TELEMETRIA_USV.h"
#include "trama_usv.h"
#include <math.h>
#include "stm32h5xx_hal_gpio.h"
#include "string.h"
#include "stdlib.h"
#include "uart.h"


#include "gps.h"
#include "adc_x.h"
#include "temp_ds18b20.h"
#include "usv_motores.h"
#include "pcb_banco.h"
#include "corriente_lem.h"

#include "stdio.h"
#include "stdlib.h"
#include "stdint.h"


/* USER CODE END Includes */

/* USER CODE BEGIN PD */

/*
 * PRUEBA 12.1:
 * La estacion puede ordenar y aplicar el rango completo -100..+100 %.
 * Se mantienen parada de emergencia y failsafe de enlace a 500 ms.
 */
#define USV_PRUEBA_MOTOR_LIMITE_PCT   100
#define USV_FAILSAFE_TIERRA_MS         500U

/* USER CODE END PD */

ADC_HandleTypeDef hadc1;
DMA_NodeTypeDef Node_GPDMA1_Channel1;
DMA_QListTypeDef List_GPDMA1_Channel1;
DMA_HandleTypeDef handle_GPDMA1_Channel1;

I2C_HandleTypeDef hi2c1;

TIM_HandleTypeDef htim3;

UART_HandleTypeDef huart1;
UART_HandleTypeDef huart2;
UART_HandleTypeDef huart3;
UART_HandleTypeDef huart6;
DMA_HandleTypeDef handle_GPDMA1_Channel0;
DMA_HandleTypeDef handle_GPDMA1_Channel2;

/* USER CODE BEGIN PV */
char texto[600];


volatile uint8_t imu_ok = 0U;
volatile uint8_t imu_addr = 0U;
volatile uint8_t imu_data_ok = 0U;

float imu_roll = 0.0f;
float imu_pitch = 0.0f;
float imu_yaw = 0.0f;

uint32_t imu_last_ms = 0U;
uint32_t teleplot_last_ms = 0U;

/* Heartbeat del lazo principal: incrementa una vez por segundo. */
uint32_t main_alive_last_ms = 0U;
uint32_t main_alive = 0U;

uint32_t temperatura_last_ms = 0U;
uint32_t temperatura_conversion_inicio_ms = 0U;
uint8_t temperatura_conversion_activa = 0U;
float temperatura_c = -100.0f;
uint8_t gps_rmc_ok = 0U;
uint8_t gps_gga_ok = 0U;
uint32_t gnss_rx_eventos = 0U;
uint32_t servo_test_last_ms = 0U;
uint8_t servo_test_estado = 0U;
float servo_test_angulo = 0.0f;
uint16_t motor_babor_pwm_us = PWM_NEUTRO;
uint16_t motor_estribor_pwm_us = PWM_NEUTRO;
uint8_t motores_pwm_activos = 0U;
uint32_t motores_test_last_ms = 0U;
uint8_t motores_test_estado = 0U;

/* Prueba local de bomba de achique por PB5 / ACHIQUE_CTRL. */
uint32_t bomba_test_last_ms = 0U;
uint8_t bomba_test_estado = 0U;

uint16_t corriente_adc_raw = 0U;
float corriente_voltaje_v = 0.0f;
float corriente_lem_a = 0.0f;

uint16_t bateria_adc_raw = 0U;
float bateria_adc_v = 0.0f;
float bateria_voltaje_v = 0.0f;

/* Ultima trama $PUSVU decodificada desde USART1 / estacion de tierra. */
USV_Comando comando_tierra;
uint8_t comando_tierra_valido = 0U;

/* Estado de control remoto para la prueba 12.0. */
int16_t cmd_babor_rx_pct = 0;
int16_t cmd_estribor_rx_pct = 0;
int16_t cmd_camara_rx_deg = 0;
int16_t motor_babor_aplicado_pct = 0;
int16_t motor_estribor_aplicado_pct = 0;
uint8_t parada_rx = 0U;
uint8_t enlace_tierra_ok = 0U;
uint8_t failsafe_tierra_activo = 1U;
uint32_t comando_tierra_ultimo_valido_ms = 0U;
uint32_t pusvu_rx_validas = 0U;

/* Diagnostico desacoplado de la recepcion para no bloquear USART1. */
uint32_t pusvu_diag_last_ms = 0U;
uint8_t pusvu_diag_pendiente = 0U;
uint8_t pusvu_diag_ultimo_valido = 0U;

char teleplot_tx[240];
uint8_t imu_raw[23];

int16_t imu_qi_raw = 0;
int16_t imu_qj_raw = 0;
int16_t imu_qk_raw = 0;
int16_t imu_qr_raw = 0;

volatile uint8_t imu_raw_ok = 0U;
volatile uint8_t imu_raw_channel = 0U;
volatile uint8_t imu_raw_report = 0U;
volatile uint16_t imu_raw_length = 0U;

/*
 * Diagnostico visual del enlace ESTACION -> BOTE.
 *
 * Mientras lleguen tramas por USART1, PB2 conmuta cada 250 ms.
 * Si pasan mas de 400 ms sin recibir nada, se detiene el parpadeo.
 */
uint32_t led_rx_ultimo_evento_ms = 0U;
uint32_t led_rx_ultimo_toggle_ms = 0U;
uint8_t led_rx_activo = 0U;
/* USER CODE END PV */

void SystemClock_Config(void);
static void MPU_Config(void);
static void MX_GPIO_Init(void);
static void MX_GPDMA1_Init(void);
static void MX_ICACHE_Init(void);
static void MX_USART1_UART_Init(void);
static void MX_USART2_UART_Init(void);
static void MX_USART6_UART_Init(void);
static void MX_I2C1_Init(void);
static void MX_TIM3_Init(void);
static void MX_USART3_UART_Init(void);
static void MX_ADC1_Init(void);
/* USER CODE BEGIN PFP */
void procesa_rx(void);
/* USER CODE END PFP */

/* USER CODE BEGIN 0 */

/*
 * Convierte los angulos reales del BNO085 al formato exigido por $PUSVD.
 *
 * - yaw:   0.0 ... 359.9 grados, almacenado x10.
 * - pitch: -90.0 ... +90.0 grados, almacenado x10.
 * - roll:  -90.0 ... +90.0 grados, almacenado x10.
 *
 * El BNO085 puede entregar roll fuera de +/-90 dependiendo de la orientacion.
 * La Trama Version 3 no admite ese rango, por eso se satura antes de enviarlo.
 */
static void USV_ActualizarTelemetriaIMU(
        float roll,
        float pitch,
        float yaw)
{
    int32_t yaw_x10;
    int32_t pitch_x10;
    int32_t roll_x10;

    while (yaw < 0.0f)
    {
        yaw += 360.0f;
    }

    while (yaw >= 360.0f)
    {
        yaw -= 360.0f;
    }

    if (pitch < -90.0f)
    {
        pitch = -90.0f;
    }
    else if (pitch > 90.0f)
    {
        pitch = 90.0f;
    }

    if (roll < -90.0f)
    {
        roll = -90.0f;
    }
    else if (roll > 90.0f)
    {
        roll = 90.0f;
    }

    yaw_x10 =
        (int32_t)((yaw * 10.0f) + 0.5f);

    pitch_x10 =
        (int32_t)((pitch >= 0.0f) ?
            ((pitch * 10.0f) + 0.5f) :
            ((pitch * 10.0f) - 0.5f));

    roll_x10 =
        (int32_t)((roll >= 0.0f) ?
            ((roll * 10.0f) + 0.5f) :
            ((roll * 10.0f) - 0.5f));

    if (yaw_x10 > 3599)
    {
        yaw_x10 = 3599;
    }

    TELEMETRIA_USV_IMU(
        &TELEMETRIA1,
        (uint16_t)yaw_x10,
        (int16_t)pitch_x10,
        (int16_t)roll_x10);
}

/*
 * Reconstruye el porcentaje con signo desde la estructura decodificada.
 * Positivo = avante, negativo = reversa.
 */
static int16_t USV_ComandoMotorFirmado(
        uint16_t potencia,
        uint8_t avante,
        uint8_t atras)
{
    if ((avante != 0U) && (atras == 0U))
    {
        return (int16_t)potencia;
    }

    if ((avante == 0U) && (atras != 0U))
    {
        return -(int16_t)potencia;
    }

    return 0;
}

/*
 * Limita el porcentaje de prueba y lo convierte a PWM ESC:
 * -100 % = 1000 us, 0 % = 1500 us, +100 % = 2000 us.
 * Para la prueba 12.1 se habilita el rango completo +/-100 %.
 */
static uint16_t USV_MotorPctAPwmPrueba(
        int16_t porcentaje,
        int16_t *porcentaje_aplicado)
{
    int16_t limitado = porcentaje;
    int32_t pwm;

    if (limitado > USV_PRUEBA_MOTOR_LIMITE_PCT)
    {
        limitado = USV_PRUEBA_MOTOR_LIMITE_PCT;
    }
    else if (limitado < -USV_PRUEBA_MOTOR_LIMITE_PCT)
    {
        limitado = -USV_PRUEBA_MOTOR_LIMITE_PCT;
    }

    if (porcentaje_aplicado != NULL)
    {
        *porcentaje_aplicado = limitado;
    }

    pwm = (int32_t)PWM_NEUTRO + ((int32_t)limitado * 5);

    if (pwm > PWM_MAX_ADELANTE)
    {
        pwm = PWM_MAX_ADELANTE;
    }
    else if (pwm < PWM_MAX_REVERSA)
    {
        pwm = PWM_MAX_REVERSA;
    }

    return (uint16_t)pwm;
}

/* void procesa_rx()
 {
  char procesa[100];
    char texto[100];
if (strstr(UARTRX1.trama_rx,"$PUSVU"))
	    {
	        strcpy(procesa, strtok(UARTRX1.trama_rx, "$"));  //inicia captura de tokens desde el =
	        strcpy(procesa, strtok(0, ","));  //captura hasta el /
strcpy(procesa, strtok(0, ","));  //captura hasta el /
strcpy(procesa, strtok(0, ","));  //captura hasta el /
strcpy(procesa, strtok(0, ","));  //captura hasta el /
strcpy(procesa, strtok(0, ","));  //captura hasta el /
strcpy(procesa, strtok(0, ","));  //captura hasta el /
 float serv=atof(procesa); // con signo
 sprintf(texto, "Servo= %.2f\r\n\r\n", serv);
 uartx_write_text(&huart1, texto);

 } 
  } */
/* USER CODE END 0 */

/**
  * @brief  The application entry point.
  * @retval int
  */
int main(void)
{

  /* MCU Configuration--------------------------------------------------------*/

  /* MPU Configuration--------------------------------------------------------*/
  MPU_Config();

  /* Reset of all peripherals, Initializes the Flash interface and the Systick. */
  HAL_Init();

  /* Configure the system clock */
  SystemClock_Config();

  /* Initialize all configured peripherals */
  MX_GPIO_Init();
  MX_GPDMA1_Init();
  MX_ICACHE_Init();
  MX_USART1_UART_Init();
  MX_USART2_UART_Init();
  MX_USART6_UART_Init();
  MX_I2C1_Init();
  MX_TIM3_Init();
  MX_USART3_UART_Init();
  MX_ADC1_Init();
  /* USER CODE BEGIN 2 */

/*
 * AUTOPRUEBA PB2:
 * Al arrancar, el LED cambia de estado durante 300 ms y vuelve al estado inicial.
 * Si este destello no se ve, el problema esta en PB2/LED y no en la UART.
 */
HAL_GPIO_WritePin(
    LED_RX_TIERRA_GPIO_Port,
    LED_RX_TIERRA_Pin,
    GPIO_PIN_SET);
HAL_Delay(300U);

HAL_GPIO_WritePin(
    LED_RX_TIERRA_GPIO_Port,
    LED_RX_TIERRA_Pin,
    GPIO_PIN_RESET);
HAL_Delay(300U);

// Inicializa la señal PWM en el pin PB0 (SERVO_CAMARA)
#if !PCB_BANCO_ACTIVO
SERVO_init(&SERVO1);
SERVO_ANG(&SERVO1, 0.0f);
#else
/* En banco, no generar PWM del servo hasta recibir orden manual. */
servo_test_angulo = 0.0f;
#endif // Posiciona inicialmente la cámara al centro (0°)

/*
 * PRUEBA LOCAL MOTORES 6.2:
 * Inicia únicamente las salidas PWM de propulsion en NEUTRO.
 * No se ejecuta USV_Motor_Calibrar() y no se ordena movimiento.
 * Babor    = PB4 / TIM3_CH1
 * Estribor = PB1 / TIM3_CH4
 */
if ((HAL_TIM_PWM_Start(&htim3, TIM_CHANNEL_1) == HAL_OK) &&
    (HAL_TIM_PWM_Start(&htim3, TIM_CHANNEL_4) == HAL_OK))
{
    USV_Motor_Set(&htim3, TIM_CHANNEL_1, PWM_NEUTRO);
    USV_Motor_Set(&htim3, TIM_CHANNEL_4, PWM_NEUTRO);

    motor_babor_pwm_us = PWM_NEUTRO;
    motor_estribor_pwm_us = PWM_NEUTRO;
    motores_pwm_activos = 1U;
}

/*
 * La prueba de bomba inicia con el rele desenergizado.
 * PB5 es open-drain y el rele es activo en LOW:
 * SET = alta impedancia = OFF.
 * RESET = 0 V = ON.
 */
HAL_GPIO_WritePin(
    ACHIQUE_CTRL_GPIO_Port,
    ACHIQUE_CTRL_Pin,
    GPIO_PIN_SET);
bomba_test_estado = 0U;
bomba_test_last_ms = HAL_GetTick();

uartx_write_text(&huart6, "INICIANDO\r\n");
#if PCB_BANCO_ACTIVO
PCB_Banco_Iniciar();
#endif
//uartRX_it_idle_dma_init(&UARTRX1);
uartRX_it_idle_dma_init(&GPS_UARTRX);   // USART1 / estacion de tierra
uartRX_it_idle_dma_init(&GNSS_UARTRX);   // USART2 / GPS L76K

// Inicializa la telemetria oficial $PUSVD por USART1 / XBee
TELEMETRIA_USV_init(&TELEMETRIA1);

// Inicializa BNO085
imu_ok = IMU_Init();
imu_addr = IMU_GetAddress7bit();

// Inicializa DS18B20 / 1-Wire en PC2 (TEMPE)
TEMPE_Init();

/*
 * Inicia ADC1 por DMA usando la libreria adc_x.
 * CubeMX tiene 3 conversiones:
 * [0] PA0, [1] PC1, [2] PC3 (humedad).
 * PC2 ya no pertenece al ADC: se usa para DS18B20 / 1-Wire.
 * Se pasa 3 de forma explicita para no modificar la libreria adc_x.
 */
ADC_Read_DMA(&hadc1, 3U, adc1_codigo);

  /* USER CODE END 2 */

  /* Infinite loop */
  /* USER CODE BEGIN WHILE */
  while (1)
  {
#if PCB_BANCO_ACTIVO
    PCB_Banco_Tarea();
#endif
    /*
     * Heartbeat de diagnostico.
     * Si main_alive sigue aumentando, el while(1) continua ejecutandose.
     */
    if ((uint32_t)(HAL_GetTick() - main_alive_last_ms) >= 1000U)
    {
        main_alive_last_ms = HAL_GetTick();
        main_alive++;
    }

    /* Lectura IMU cada 50 ms */
    if ((HAL_GetTick() - imu_last_ms) >= 50U)
    {
        imu_last_ms = HAL_GetTick();

        if (IMU_ReadEuler(
                &imu_roll,
                &imu_pitch,
                &imu_yaw) != 0U)
        {
            imu_data_ok = 1U;

            USV_ActualizarTelemetriaIMU(
                imu_roll,
                imu_pitch,
                imu_yaw);
        }
    }

    /*
     * PRUEBA 12.0:
     * Servo y motores ya no se fuerzan aqui a una posicion fija.
     * Las salidas se actualizan exclusivamente cuando llega una $PUSVU
     * valida y por el failsafe de perdida de enlace definido mas abajo.
     */

    /*
     * PRUEBA 12.0:
     * La bomba permanece desactivada. Esta etapa habilita unicamente
     * servo de camara y los dos motores de propulsion.
     */
#if !PCB_BANCO_ACTIVO
    HAL_GPIO_WritePin(
        ACHIQUE_CTRL_GPIO_Port,
        ACHIQUE_CTRL_Pin,
        GPIO_PIN_SET);
    bomba_test_estado = 0U;
#endif

    /*
     * TEMPERATURA DS18B20 NO BLOQUEANTE:
     *
     * La conversion se inicia cada 2 s y el main continua ejecutandose.
     * Transcurridos 750 ms se lee el scratchpad. De esta forma USART1,
     * Teleplot, IMU y el resto de tareas siguen siendo atendidos durante
     * el tiempo de conversion del sensor.
     */
    {
        uint32_t ahora_temp = HAL_GetTick();

        if (temperatura_conversion_activa == 0U)
        {
            if ((uint32_t)(ahora_temp - temperatura_last_ms) >= 2000U)
            {
                temperatura_last_ms = ahora_temp;

                if (TEMPE_StartConversion() != 0U)
                {
                    temperatura_conversion_inicio_ms = ahora_temp;
                    temperatura_conversion_activa = 1U;
                }
                else
                {
                    temperatura_c = -100.0f;
                }
            }
        }
        else if ((uint32_t)(ahora_temp - temperatura_conversion_inicio_ms) >= 750U)
        {
            temperatura_c = TEMPE_ReadResult();
            temperatura_conversion_activa = 0U;
        }
    }

    /*
     * TELEPLOT SEGURO 11.4:
     * Se limita a 2 Hz para reducir la carga de USART6 durante la prueba
     * continua de comunicacion con la estacion de tierra.
     */
    if ((HAL_GetTick() - teleplot_last_ms) >= 500U)
    {
        float humedad_pct;
        int len;

        teleplot_last_ms = HAL_GetTick();

        /*
         * SENSOR DE CORRIENTE LEM HASS 200-S:
         * PA0 = ADC1_INP0 = adc1_codigo[0].
         * Se conserva intacta la libreria corriente_lem.
         */
        corriente_adc_raw = adc1_codigo[0];
        corriente_voltaje_v =
            ((float)corriente_adc_raw / STM32_ADC_MAX_CODES) *
            STM32_ADC_VREF;
        corriente_lem_a =
            LEM_HASS200_ObtenerCorriente(corriente_adc_raw);

        /*
         * SENSOR DE VOLTAJE DE BATERIA:
         * PC1 = ADC1_INP11 = adc1_codigo[1].
         * Divisor nominal: R1=20 kOhm, R2=4.7 kOhm.
         * Factor nominal = (20k + 4.7k) / 4.7k = 5.255.
         *
         * Para esta primera prueba se usa el factor nominal y se compara
         * contra el multimetro antes de aplicar cualquier calibracion.
         */
        bateria_adc_raw = adc1_codigo[1];
        bateria_adc_v =
            ((float)bateria_adc_raw / 4095.0f) * 3.3f;
        bateria_voltaje_v =
            bateria_adc_v * 5.255f;

        /*
         * INTEGRACION $PUSVD 9.1:
         * Convierte las mediciones electricas al formato x10 de la trama.
         * Se preservan temperatura e inundacion hasta integrarlas en su etapa.
         */
        {
            float bateria_tx_v = bateria_voltaje_v;
            float corriente_tx_a = corriente_lem_a;
            uint16_t bateria_tx_x10;
            uint16_t corriente_tx_x10;

            if (bateria_tx_v < 0.0f)
            {
                bateria_tx_v = 0.0f;
            }
            else if (bateria_tx_v > 14.0f)
            {
                bateria_tx_v = 14.0f;
            }

            if (corriente_tx_a < 0.0f)
            {
                corriente_tx_a = 0.0f;
            }
            else if (corriente_tx_a > 100.0f)
            {
                corriente_tx_a = 100.0f;
            }

            bateria_tx_x10 =
                (uint16_t)((bateria_tx_v * 10.0f) + 0.5f);

            corriente_tx_x10 =
                (uint16_t)((corriente_tx_a * 10.0f) + 0.5f);

            TELEMETRIA_USV_SENSORES(
                &TELEMETRIA1,
                TELEMETRIA1.datos.temperatura_x10,
                TELEMETRIA1.datos.inundacion,
                bateria_tx_x10,
                corriente_tx_x10);
        }

        humedad_pct =
            ((4095.0f - (float)adc1_codigo[2]) * 100.0f) /
            (4095.0f - 1466.0f);

        if (humedad_pct < 0.0f)
        {
            humedad_pct = 0.0f;
        }
        else if (humedad_pct > 100.0f)
        {
            humedad_pct = 100.0f;
        }

        /* Bloque 1: sensores basicos y servo. */
        len = snprintf(
            texto,
            sizeof(texto),
            ">humedad_adc:%u\r\n"
            ">humedad_pct:%.1f\r\n"
            ">temperatura_c:%.2f\r\n"
            ">servo_angulo:%.1f\r\n"
            ">servo_pwm_us:%lu\r\n"
            ">cmd_babor_rx_pct:%d\r\n"
            ">cmd_estribor_rx_pct:%d\r\n"
            ">cmd_camara_rx_deg:%d\r\n"
            ">motor_babor_aplicado_pct:%d\r\n"
            ">motor_estribor_aplicado_pct:%d\r\n"
            ">motores_pwm_activos:%u\r\n"
            ">motor_babor_pwm_us:%u\r\n"
            ">motor_estribor_pwm_us:%u\r\n"
            ">parada_rx:%u\r\n"
            ">enlace_tierra_ok:%u\r\n"
            ">failsafe_tierra:%u\r\n"
            ">pusvu_rx_validas:%lu\r\n"
            ">bomba_achique:%u\r\n"
            ">main_alive:%lu\r\n",
            (unsigned int)adc1_codigo[2],
            humedad_pct,
            temperatura_c,
            servo_test_angulo,
            (unsigned long)TIM3->CCR3,
            (int)cmd_babor_rx_pct,
            (int)cmd_estribor_rx_pct,
            (int)cmd_camara_rx_deg,
            (int)motor_babor_aplicado_pct,
            (int)motor_estribor_aplicado_pct,
            (unsigned int)motores_pwm_activos,
            (unsigned int)motor_babor_pwm_us,
            (unsigned int)motor_estribor_pwm_us,
            (unsigned int)parada_rx,
            (unsigned int)enlace_tierra_ok,
            (unsigned int)failsafe_tierra_activo,
            (unsigned long)pusvu_rx_validas,
            (unsigned int)bomba_test_estado,
            (unsigned long)main_alive);

        if ((len > 0) && ((size_t)len < sizeof(texto)))
        {
            uartx_write_text(&huart6, texto);
        }

        /* Bloque 2: diagnostico IMU. */
        len = snprintf(
            texto,
            sizeof(texto),
            ">imu_ok:%u\r\n"
            ">imu_addr:%u\r\n"
            ">imu_data_ok:%u\r\n"
            ">roll:%.2f\r\n"
            ">pitch:%.2f\r\n"
            ">yaw:%.2f\r\n",
            (unsigned int)imu_ok,
            (unsigned int)imu_addr,
            (unsigned int)imu_data_ok,
            imu_roll,
            imu_pitch,
            imu_yaw);

        if ((len > 0) && ((size_t)len < sizeof(texto)))
        {
            uartx_write_text(&huart6, texto);
        }

        /* Bloque 3: estado de recepcion GNSS. */
        len = snprintf(
            texto,
            sizeof(texto),
            ">gnss_rx_eventos:%lu\r\n"
            ">gnss_rx_bytes:%u\r\n"
            ">gps_rmc_ok:%u\r\n"
            ">gps_gga_ok:%u\r\n"
            ">gps_fix:%d\r\n"
            ">gps_satelites:%d\r\n"
            ">gps_hdop:%.2f\r\n",
            (unsigned long)gnss_rx_eventos,
            (unsigned int)GNSS_UARTRX.num_datos,
            (unsigned int)gps_rmc_ok,
            (unsigned int)gps_gga_ok,
            (int)gps_modo,
            (int)gps_satelites,
            gps_hor_dilu);

        if ((len > 0) && ((size_t)len < sizeof(texto)))
        {
            uartx_write_text(&huart6, texto);
        }

        /* Bloque 4: datos de navegacion GNSS. */
        len = snprintf(
            texto,
            sizeof(texto),
            ">gps_latitud:%.6f\r\n"
            ">gps_longitud:%.6f\r\n"
            ">gps_altitud_m:%.2f\r\n"
            ">gps_velocidad_kph:%.2f\r\n"
            ">gps_rumbo:%.2f\r\n",
            latitud,
            longitud,
            gps_altura,
            gps_vel_kph,
            gps_rumbo);

        if ((len > 0) && ((size_t)len < sizeof(texto)))
        {
            uartx_write_text(&huart6, texto);
        }

        /* Bloque 5: sensor de corriente LEM por PA0 / ADC1_INP0. */
        len = snprintf(
            texto,
            sizeof(texto),
            ">corriente_adc:%u\r\n"
            ">corriente_voltaje_v:%.3f\r\n"
            ">corriente_a:%.2f\r\n",
            (unsigned int)corriente_adc_raw,
            corriente_voltaje_v,
            corriente_lem_a);

        if ((len > 0) && ((size_t)len < sizeof(texto)))
        {
            uartx_write_text(&huart6, texto);
        }

        /* Bloque 6: voltaje de bateria por PC1 / ADC1_INP11. */
        len = snprintf(
            texto,
            sizeof(texto),
            ">bateria_adc:%u\r\n"
            ">bateria_adc_v:%.3f\r\n"
            ">bateria_voltaje_v:%.2f\r\n",
            (unsigned int)bateria_adc_raw,
            bateria_adc_v,
            bateria_voltaje_v);

        if ((len > 0) && ((size_t)len < sizeof(texto)))
        {
            uartx_write_text(&huart6, texto);
        }
#if PCB_BANCO_ACTIVO
        len = snprintf(texto, sizeof(texto),
            ">pcb_armado:%u\r\n>pcb_motor_pulso:%u\r\n"
            ">pcb_bomba_pulso:%u\r\n>pcb_do_pulso:%u\r\n"
            ">di1:%u\r\n>di2:%u\r\n>di3:%u\r\n>di4:%u\r\n"
            ">humedad_do:%u\r\n",
            (unsigned int)PCB_Banco_Armado(),
            (unsigned int)PCB_Banco_MotorActivo(),
            (unsigned int)PCB_Banco_BombaActiva(),
            (unsigned int)PCB_Banco_SalidaActiva(),
            (unsigned int)HAL_GPIO_ReadPin(DI1_PA4_GPIO_Port, DI1_PA4_Pin),
            (unsigned int)HAL_GPIO_ReadPin(DI2_PA5_GPIO_Port, DI2_PA5_Pin),
            (unsigned int)HAL_GPIO_ReadPin(DI3_PA6_GPIO_Port, DI3_PA6_Pin),
            (unsigned int)HAL_GPIO_ReadPin(DI4_PA7_GPIO_Port, DI4_PA7_Pin),
            (unsigned int)HAL_GPIO_ReadPin(HUMIDITY_DO_GPIO_Port, HUMIDITY_DO_Pin));
        if ((len > 0) && ((size_t)len < sizeof(texto)))
            uartx_write_text(&huart6, texto);
#endif
    }

    /* Envío a Teleplot cada 200 ms */
    /* if ((HAL_GetTick() - teleplot_last_ms) >= 200U)
    {
        teleplot_last_ms = HAL_GetTick();

        int len = snprintf(
            teleplot_tx,
            sizeof(teleplot_tx),
            ">imu_ok:%u\r\n"
            ">imu_addr:%u\r\n"
            ">imu_data_ok:%u\r\n"
            ">roll:%.2f\r\n"
            ">pitch:%.2f\r\n"
            ">yaw:%.2f\r\n"
            ">rx_eventos:%lu\r\n"
            ">tramas_validas:%lu\r\n"
            ">camara_rx:%d\r\n"
            ">servo_ccr3:%lu\r\n"
            ">pb2_estado:%u\r\n"
            ">enlace_tierra:%u\r\n",
            (unsigned int)imu_ok,
            (unsigned int)imu_addr,
            (unsigned int)imu_data_ok,
            imu_roll,
            imu_pitch,
            imu_yaw,
            (unsigned long)usv_rx_eventos,
            (unsigned long)usv_tramas_validas,
            (int)usv_camara_recibida,
            (unsigned long)TIM3->CCR3,
            (unsigned int)HAL_GPIO_ReadPin(
                LED_RX_TIERRA_GPIO_Port,
                LED_RX_TIERRA_Pin),
            (unsigned int)led_rx_activo);

        if (len > 0)
        {
            HAL_UART_Transmit(
                &huart6,
                (uint8_t *)teleplot_tx,
                (uint16_t)len,
                100U);
        }
    } */

    /*
     * PRUEBA 12.0 - CONTROL REAL DESDE $PUSVU:
     *
     * Una trama valida actualiza inmediatamente:
     * - servo PB0 / TIM3_CH3;
     * - motor babor PB4 / TIM3_CH1;
     * - motor estribor PB1 / TIM3_CH4.
     *
     * Los motores usan el rango completo -100..+100 %.
     * parada=1 mantiene ambos ESC en NEUTRO.
     */
    if (GPS_UARTRX.flag_rx == 1)
    {
        uint32_t ahora_rx = HAL_GetTick();

        led_rx_ultimo_evento_ms = ahora_rx;
        led_rx_activo = 1U;

        comando_tierra_valido =
            USV_LeerComando(
                (const char *)GPS_UARTRX.trama_rx,
                &comando_tierra);

        pusvu_diag_ultimo_valido = comando_tierra_valido;
        pusvu_diag_pendiente = 1U;

        if (comando_tierra_valido != 0U)
        {
            cmd_babor_rx_pct =
                USV_ComandoMotorFirmado(
                    comando_tierra.potencia_babor,
                    comando_tierra.babor_avante,
                    comando_tierra.babor_atras);

            cmd_estribor_rx_pct =
                USV_ComandoMotorFirmado(
                    comando_tierra.potencia_estribor,
                    comando_tierra.estribor_avante,
                    comando_tierra.estribor_atras);

            cmd_camara_rx_deg = comando_tierra.camara;
            parada_rx = comando_tierra.parada;

            comando_tierra_ultimo_valido_ms = ahora_rx;
            enlace_tierra_ok = 1U;
            failsafe_tierra_activo = 0U;
            pusvu_rx_validas++;

#if !PCB_BANCO_ACTIVO
            /* La camara sigue directamente el comando -90..+90 grados. */
            servo_test_angulo = (float)cmd_camara_rx_deg;
            SERVO_ANG(&SERVO1, servo_test_angulo);

            if ((parada_rx != 0U) || (motores_pwm_activos == 0U))
            {
                motor_babor_aplicado_pct = 0;
                motor_estribor_aplicado_pct = 0;
                motor_babor_pwm_us = PWM_NEUTRO;
                motor_estribor_pwm_us = PWM_NEUTRO;
            }
            else
            {
                motor_babor_pwm_us =
                    USV_MotorPctAPwmPrueba(
                        cmd_babor_rx_pct,
                        &motor_babor_aplicado_pct);

                motor_estribor_pwm_us =
                    USV_MotorPctAPwmPrueba(
                        cmd_estribor_rx_pct,
                        &motor_estribor_aplicado_pct);
            }

            if (motores_pwm_activos != 0U)
            {
                USV_Motor_Set(
                    &htim3,
                    TIM_CHANNEL_1,
                    motor_babor_pwm_us);

                USV_Motor_Set(
                    &htim3,
                    TIM_CHANNEL_4,
                    motor_estribor_pwm_us);
            }
#endif
        }

        /*
         * Prioridad: reactivar USART1 inmediatamente.
         * La impresion del diagnostico se realiza despues.
         */
        uartRX_DMA_Re_init(&GPS_UARTRX);
    }

    /*
     * FAILSAFE DE ENLACE:
     * Si pasan mas de 500 ms sin una $PUSVU valida, ambos motores vuelven
     * a NEUTRO. El servo conserva la ultima posicion recibida.
     */
#if !PCB_BANCO_ACTIVO
    if ((enlace_tierra_ok != 0U) &&
        ((uint32_t)(HAL_GetTick() - comando_tierra_ultimo_valido_ms) >
         USV_FAILSAFE_TIERRA_MS))
    {
        enlace_tierra_ok = 0U;
        failsafe_tierra_activo = 1U;

        motor_babor_aplicado_pct = 0;
        motor_estribor_aplicado_pct = 0;
        motor_babor_pwm_us = PWM_NEUTRO;
        motor_estribor_pwm_us = PWM_NEUTRO;

        if (motores_pwm_activos != 0U)
        {
            USV_Motor_Set(
                &htim3,
                TIM_CHANNEL_1,
                motor_babor_pwm_us);

            USV_Motor_Set(
                &htim3,
                TIM_CHANNEL_4,
                motor_estribor_pwm_us);
        }
    }

#endif
    /*
     * Diagnostico $PUSVU por USART6 limitado a 500 ms.
     * Siempre muestra la ultima orden recibida.
     */
    if ((pusvu_diag_pendiente != 0U) &&
        ((uint32_t)(HAL_GetTick() - pusvu_diag_last_ms) >= 500U))
    {
        int len_rx;

        if (pusvu_diag_ultimo_valido != 0U)
        {
            int16_t babor_signed = 0;
            int16_t estribor_signed = 0;

            if (comando_tierra.babor_avante != 0U)
            {
                babor_signed =
                    (int16_t)comando_tierra.potencia_babor;
            }
            else if (comando_tierra.babor_atras != 0U)
            {
                babor_signed =
                    -(int16_t)comando_tierra.potencia_babor;
            }

            if (comando_tierra.estribor_avante != 0U)
            {
                estribor_signed =
                    (int16_t)comando_tierra.potencia_estribor;
            }
            else if (comando_tierra.estribor_atras != 0U)
            {
                estribor_signed =
                    -(int16_t)comando_tierra.potencia_estribor;
            }

            len_rx = snprintf(
                texto,
                sizeof(texto),
                "\r\n"
                "===== PUSVU DECODIFICADA =====\r\n"
                "PUSVU_OK          : 1\r\n"
                "Babor recibido    : %d %%\r\n"
                "Estribor recibido : %d %%\r\n"
                "Babor avante      : %u\r\n"
                "Babor atras       : %u\r\n"
                "Estribor avante   : %u\r\n"
                "Estribor atras    : %u\r\n"
                "Camara            : %d grados\r\n"
                "Bomba             : %u\r\n"
                "Parada emergencia : %u\r\n"
                "Babor aplicado    : %d %% / %u us\r\n"
                "Estribor aplicado : %d %% / %u us\r\n"
                "Failsafe enlace   : %u\r\n"
                "==============================\r\n",
                (int)babor_signed,
                (int)estribor_signed,
                (unsigned int)comando_tierra.babor_avante,
                (unsigned int)comando_tierra.babor_atras,
                (unsigned int)comando_tierra.estribor_avante,
                (unsigned int)comando_tierra.estribor_atras,
                (int)comando_tierra.camara,
                (unsigned int)comando_tierra.bomba,
                (unsigned int)comando_tierra.parada,
                (int)motor_babor_aplicado_pct,
                (unsigned int)motor_babor_pwm_us,
                (int)motor_estribor_aplicado_pct,
                (unsigned int)motor_estribor_pwm_us,
                (unsigned int)failsafe_tierra_activo);
        }
        else
        {
            len_rx = snprintf(
                texto,
                sizeof(texto),
                "\r\n"
                "===== PUSVU INVALIDA =====\r\n"
                "PUSVU_OK : 0\r\n"
                "==========================\r\n");
        }

        if ((len_rx > 0) && ((size_t)len_rx < sizeof(texto)))
        {
            uartx_write_text(&huart6, texto);
        }

        pusvu_diag_last_ms = HAL_GetTick();
        pusvu_diag_pendiente = 0U;
    }

    /*
     * GPS L76K / USART2:
     * La libreria gps.c busca RMC y GGA dentro del buffer NMEA recibido.
     * Los indicadores gps_rmc_ok / gps_gga_ok quedan enclavados cuando
     * se obtiene por primera vez una sentencia valida con solucion.
     */
    if (GNSS_UARTRX.flag_rx == 1)
    {
        uint8_t rmc_ok;
        uint8_t gga_ok;

        gnss_rx_eventos++;

        rmc_ok = GPS_RMC();
        gga_ok = GPS_GGA();

        if (rmc_ok != 0U)
        {
            gps_rmc_ok = 1U;
        }

        if (gga_ok != 0U)
        {
            gps_gga_ok = 1U;
        }

        uartRX_DMA_Re_init(&GNSS_UARTRX);
    }

    /*
     * PRUEBA SOLICITADA POR EL PROFESOR:
     * PB2 parpadea aproximadamente a 2 Hz mientras se siguen recibiendo
     * tramas desde la estacion de tierra.
     */
    if (led_rx_activo != 0U)
    {
        uint32_t ahora_led = HAL_GetTick();

        if ((uint32_t)(ahora_led - led_rx_ultimo_evento_ms) > 400U)
        {
            /* No han llegado tramas recientemente: detiene el parpadeo. */
            led_rx_activo = 0U;
            HAL_GPIO_WritePin(
                LED_RX_TIERRA_GPIO_Port,
                LED_RX_TIERRA_Pin,
                GPIO_PIN_RESET);
        }
        else if ((uint32_t)(ahora_led - led_rx_ultimo_toggle_ms) >= 250U)
        {
            led_rx_ultimo_toggle_ms = ahora_led;

            HAL_GPIO_TogglePin(
                LED_RX_TIERRA_GPIO_Port,
                LED_RX_TIERRA_Pin);
        }
    }

    /* Envia $PUSVD hacia tierra cada 500 ms. */
    TELEMETRIA_USV_Tarea(&TELEMETRIA1);

    /* USER CODE END WHILE */

    /* USER CODE BEGIN 3 */
  }
  /* USER CODE END 3 */
}

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
 /* MPU Configuration */

void MPU_Config(void)
{
  MPU_Region_InitTypeDef MPU_InitStruct = {0};
  MPU_Attributes_InitTypeDef MPU_AttributesInit = {0};

  /* Disables the MPU */
  HAL_MPU_Disable();

  /** Initializes and configures the Region 0 and the memory to be protected
  */
  MPU_InitStruct.Enable = MPU_REGION_ENABLE;
  MPU_InitStruct.Number = MPU_REGION_NUMBER0;
  MPU_InitStruct.BaseAddress = 0x08FFF000;
  MPU_InitStruct.LimitAddress = 0x08FFFFFF;
  MPU_InitStruct.AttributesIndex = MPU_ATTRIBUTES_NUMBER0;
  MPU_InitStruct.AccessPermission = MPU_REGION_ALL_RO;
  MPU_InitStruct.DisableExec = MPU_INSTRUCTION_ACCESS_DISABLE;
  MPU_InitStruct.IsShareable = MPU_ACCESS_NOT_SHAREABLE;

  HAL_MPU_ConfigRegion(&MPU_InitStruct);

  /** Initializes and configures the Attribute 0 and the memory to be protected
  */
  MPU_AttributesInit.Number = MPU_ATTRIBUTES_NUMBER0;
  MPU_AttributesInit.Attributes = INNER_OUTER(MPU_NOT_CACHEABLE);

  HAL_MPU_ConfigMemoryAttributes(&MPU_AttributesInit);
  /* Enables the MPU */
  HAL_MPU_Enable(MPU_PRIVILEGED_DEFAULT);

}

/**
  * @brief  This function is executed in case of error occurrence.
  * @param None
  * @retval None
  */
void Error_Handler(void)
{
  /* USER CODE BEGIN Error_Handler_Debug */
  /* User can add his own implementation to report the HAL error return state */
  __disable_irq();
  while (1)
  {
  }
  /* USER CODE END Error_Handler_Debug */
}
#ifdef USE_FULL_ASSERT
/**
  * @brief  Reports the name of the source file and the source line number
  *         where the assert_param error has occurred.
  * @param  file: pointer to the source file name
  * @param  line: assert_param error line source number
  * @retval None
  */
void assert_failed(uint8_t *file, uint32_t line)
{
  /* USER CODE BEGIN 6 */
  /* User can add his own implementation to report the file name and line number,
     ex: printf("Wrong parameters value: file %s on line %d\r\n", file, line) */
  /* USER CODE END 6 */
}
#endif /* USE_FULL_ASSERT */
