RAFHA2413/Control_Navegacion_USV_STM32H562VGT6_v03/Control_Navegacion_USV_STM32H562VGT6_v03.ioc

Mcu.UserName=STM32H562VGTx
PA0.Signal=ADCx_INP0
PA10.Signal=USART1_RX
PA13(JTMS/SWDIO).Signal=DEBUG_JTMS-SWDIO
PA14(JTCK/SWCLK).Signal=DEBUG_JTCK-SWCLK
PA2.GPIO_Label=USART2_TX_GNSS
PA2.Signal=USART2_TX
PA3.GPIO_Label=USART2_RX_GNSS
PA3.Signal=USART2_RX
PA4.GPIO_Label=DI1_PA4
PA4.Signal=GPIO_Input
PA5.GPIO_Label=DI2_PA5
PA5.Signal=GPIO_Input
PA6.GPIO_Label=DI3_PA6
PA6.Signal=GPIO_Input
PA7.GPIO_Label=DI4_PA7
PA7.Signal=GPIO_Input
PA9.Signal=USART1_TX
PB0.GPIO_Label=SERVO_CAMARA
PB0.Signal=S_TIM3_CH3
PB1.Signal=S_TIM3_CH4
PB12.GPIO_Label=DO1_PB12
PB12.Signal=GPIO_Output
PB13.GPIO_Label=DO2_PB13
PB13.Signal=GPIO_Output
PB14.GPIO_Label=DO3_PB14
PB14.Signal=GPIO_Output
PB15.GPIO_Label=DO4_PB15
PB15.Signal=GPIO_Output
PB2.GPIO_Label=LED
PB2.Signal=GPIO_Output
PB4(NJTRST).Signal=S_TIM3_CH1
PB5.GPIO_Label=ACHIQUE_CTRL
PB5.Signal=GPIO_Output
PB6.Signal=I2C1_SCL
PB7.Signal=I2C1_SDA
PC1.Signal=ADCx_INP11
PC2.GPIO_Label=TEMPE
PC2.Signal=GPIO_Output
PC3.Signal=ADCx_INP13
PC4.GPIO_Label=HUMIDITY_DO
PC4.Signal=GPIO_Input
PC6.GPIO_Label=USART6_TX_DATA
PC6.Signal=USART6_TX
PC7.GPIO_Label=USART6_RX_DATA
PC7.Signal=USART6_RX
PD8.GPIO_Label=NEXTION_TX
PD8.Signal=USART3_TX
PD9.GPIO_Label=NEXTION_RX
PD9.Signal=USART3_RX
