RAFHA2413/Control_Navegacion_USV_STM32H562VGT6_v03/(commit log)

2026-09-16 Integracion UART servo y telemetria USV
2026-09-17 correccion imu alices
2026-09-17 correccion imu 4
2026-09-17 carreccion imu 5
2026-09-17 correcion imu 6
2026-09-17 correccion imu 7
2026-09-17 Integrar telemetria PUSVD e IMU con trama vigente
2026-09-17 Prueba automatica temporal servo camara
2026-09-17 Prueba automatica servo a 90 grados
2026-09-17 Prueba continua servo entre -90 y +90 grados
2026-09-17 Integrar servo MG996R con control remoto y Teleplot
2026-09-17 Agregar diagnostico UART para prueba de servo
2026-09-17 Contabilizar tramas y angulo de camara recibidos
2026-09-17 Mostrar diagnostico de servo y UART en Teleplot
2026-09-17 Aislar control remoto del servo para prueba local
2026-09-17 Probar servo localmente manteniendo IMU y Teleplot
2026-09-17 Aislar integracion tierra a servo de camara
2026-09-17 Mantener Teleplot durante prueba con micro de tierra
2026-09-17 Restaurar Teleplot estable para prueba de integracion
2026-09-17 Restaurar recepcion normal de camara desde tierra
2026-09-17 Definir LED PB2 para prueba de enlace con tierra
2026-09-17 Parpadear PB2 al recibir señal de la estacion de tierra
2026-09-17 Robustecer prueba PB2 de recepcion desde tierra
2026-09-18 version alcides con libreria uart ojo no se pueden modificar librerias
2026-09-18 Integrar servo con trama PUSVU sin modificar librerias
2026-09-19 1.1 SE AGREGARON LIBRERIAS HUMEDAD_SENSOR PARA INICIAR PRUEBAS DEL SENSOR DE HUMEDAD
2026-09-19 1.2 SE AGREGARON LIBRERIAS ADC PARA EL SENSOR DE HUMEDAD
2026-09-19 1.3 CONFIGURACION ADC EN EL MICRO PARA EL SENSOR DE HUMEDAD
2026-09-19 1.4 PRUEBA ADC SENSOR DE HUMEDAD EN TELEPLOT
2026-09-19 1.5 ELIMINE LIBRERIAS DE HUMEDAD PARA TRABAJAR CON SOLO LAS DE ADC DE ALCIDES
2026-09-19 1.6 CONVERSION PORCENTAJE SENSOR DE HUMEDAD EN TELEPLOT
2026-09-19 1.5.1 DESHABILITAR INTERRUPCION GPDMA1 CH1 PARA ADC HUMEDAD
2026-09-19 2. TRAMA Y SENSOR DE HUMEDAD ADC LISTOS
2026-09-19 2.1 SE AGREGO LIBRERIA DEL SENSOR DE TEMPERATURA DS18B20
2026-09-19 2.2 cambio de configuracion pc2 gpio para sensor de temperatura
2026-09-19 2.3 INTEGRAR DS18B20 Y AJUSTAR ADC DE HUMEDAD
2026-09-19 3. TRAMA + HUMEDAD ADC + TEMPERATURA DS18B20 LISTOS
2026-09-19 3.1 PRUEBA LOCAL SERVO MG996R EN TELEPLOT
2026-09-21 4. INTEGRAR IMU BNO085 EN TELEPLOT
2026-09-21 5.7 PRUEBA VIDA PB2 DESPUES DE I2C1
2026-09-21 5.13 AISLAR INICIALIZACION GNSS DMA
2026-09-21 5.15 AISLAR LECTURA PERIODICA IMU
2026-09-21 5.18 REHABILITAR LECTURA PERIODICA IMU
2026-09-21 5.19 REHABILITAR RECEPCION DMA GPS L76K
2026-09-21 6. GPS FUNCIONANDO INICIAMOS CON LOS MOTORES AGREGUE LIBRERIAS PARA LOS MOTORES
2026-09-21 6.2 INICIAR PWM MOTORES EN NEUTRO Y TELEPLOT
2026-09-21 6.3 PRUEBA LOCAL MOTOR BABOR 1500 1550 US
2026-09-21 6.4 PRUEBA LOCAL MOTOR ESTRIBOR 1500 1550 US
2026-09-21 6.5 PRUEBA LOCAL AMBOS MOTORES 1500 1550 US
2026-09-21 6.6 PRUEBA MAXIMA AVANTE MOTORES INTERCALADOS
2026-09-21 6.7 PRUEBA BABOR AVANTE ESTRIBOR REVERSA FIJOS
    [main.c]
2026-09-22 7. AGREGUE LIBRERIAS SENSOR DE CORRIENTE LEM
2026-09-22 7.1 INTEGRAR SENSOR CORRIENTE LEM EN TELEPLOT
2026-09-22 7.2 PRUEBA LEM MOTORES EN NEUTRO
2026-09-23 8. AGREGUE LIBRERIAS SENSOR DE BATERIA Y MOTORES
2026-09-23 8.1 PRUEBA SENSOR VOLTAJE BATERIA EN PC1
2026-09-23 8.2 CORREGIR NOMBRES LIBRERIA BATERIA MOTORES
2026-09-24 9.1 INTEGRAR VOLTAJE Y CORRIENTE EN TRAMA PUSVD
2026-09-24 10.1 PRUEBA LOCAL BOMBA DE ACHIQUE Y SENSORES
2026-10-02 11. elimine librerias viejas de la trama de estacion de tierra inicio la integracion de la estacion en tierra
2026-10-02 11.1 agregue librerias trama_usv para iniciar la intergracion con la estacuion de control de la USV
2026-10-13 12.0 CONTROL SERVO Y MOTORES DESDE PUSVU
2026-10-13 12.1 HABILITA MOTORES AL 100 PORCIENTO DESDE PUSVU
2026-10-19 13.0 Prueba integral PCB A193: USART6, actuadores temporizados y seguridad banco
2026-10-19 13.1 Seguridad banco: servo sin PWM hasta orden manual ARM
2026-10-19 13.2 Banco: habilitar PWM servo una sola vez, permitir comandos sucesivos
2026-10-19 docs: protocolo académico PCB A193 v1.0 y matriz de trazabilidad 19 ensayos
2026-10-19 docs: publicar version 1.1 de matriz basada en commits y equipos reales
2026-10-19 docs: v1.2 aclarar Nextion como conector reservado fuera de alcance USV actual
2026-10-23 Preparar carpeta de evidencias experimentales USV
2026-10-23 Preparar importación automática con verificación SHA-256 de las pruebas USV
2026-10-23 Incorporar 39 evidencias originales verificadas de la PCB USV
2026-10-23 Documentar integridad y estructura del libro de pruebas P20–P29
2026-10-23 Agregar verificación automática SHA-256 de evidencia Excel P20–P29
